Polarix/kicad_libs_append/3d_model/JST1.25mm_2P_Ver_THT.stp

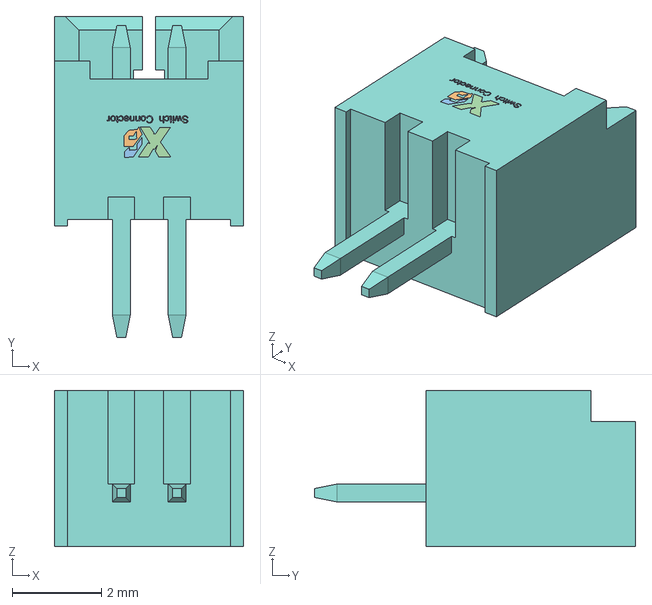
[picture p1: CAD file, 2026-07-21]
3d_model/JST1.25mm_2P_Ver_THT.stp
4.25 x 7.20 x 3.50 mm
