Polarix/kicad_libs_append/3d_model/JST1.25mm_6P_Hor_THT.stp

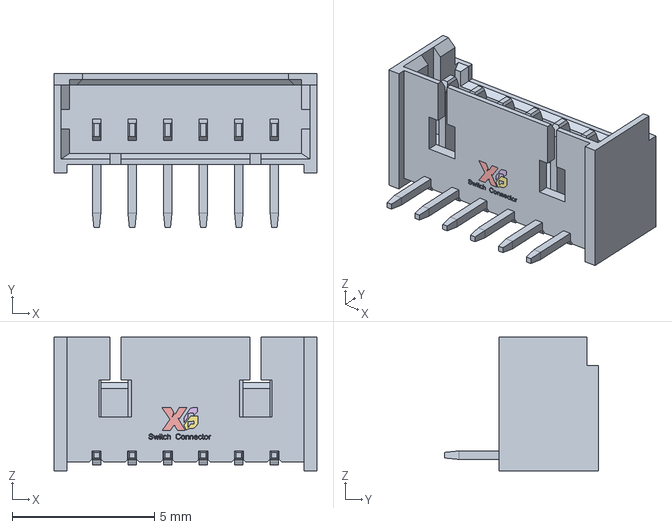
[picture p3: CAD file, 2026-07-21]
3d_model/JST1.25mm_6P_Hor_THT.stp
9.25 x 5.40 x 4.70 mm
