Polarix/kicad_libs_append/3d_model/JST1.25mm_3P_Ver_THT.stp

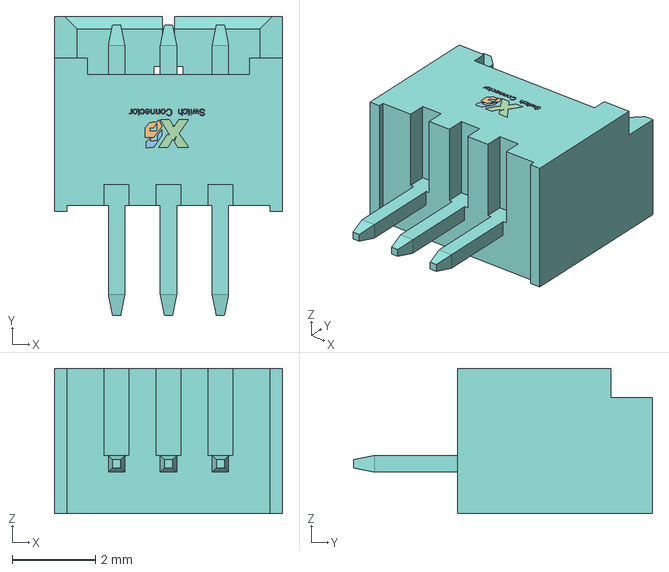
[picture p6: CAD file, 2026-07-21]
3d_model/JST1.25mm_3P_Ver_THT.stp
5.50 x 7.20 x 3.50 mm
