Polarix/kicad_libs_append/3d_model/JST1.25mm_3P_Hor_THT.stp

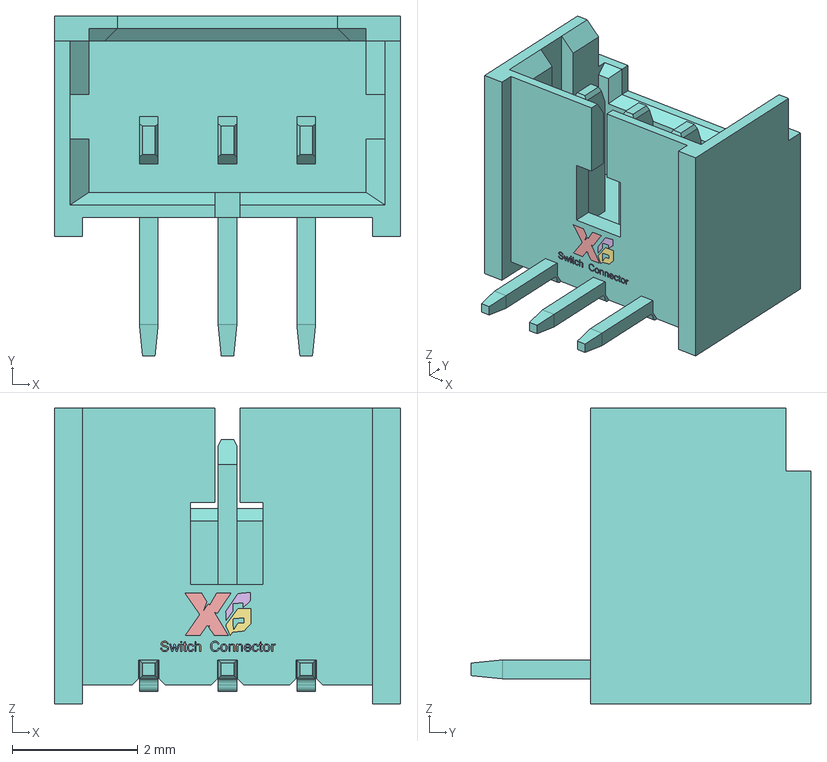
[picture p7: CAD file, 2026-07-21]
3d_model/JST1.25mm_3P_Hor_THT.stp
5.50 x 5.40 x 4.70 mm
