Polarix/kicad_libs_append/3d_model/JST1.25mm_3P_Hor_SMD.stp

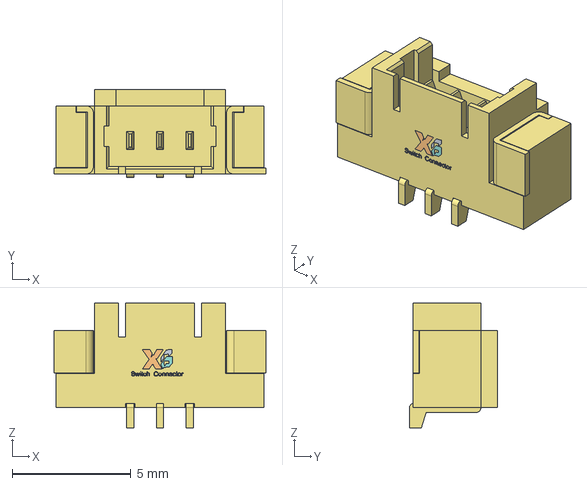
[picture p8: CAD file, 2026-07-21]
3d_model/JST1.25mm_3P_Hor_SMD.stp
8.91 x 3.70 x 5.25 mm
