Polarix/kicad_libs_append/3d_model/JST1.25mm_4P_Ver_THT.stp

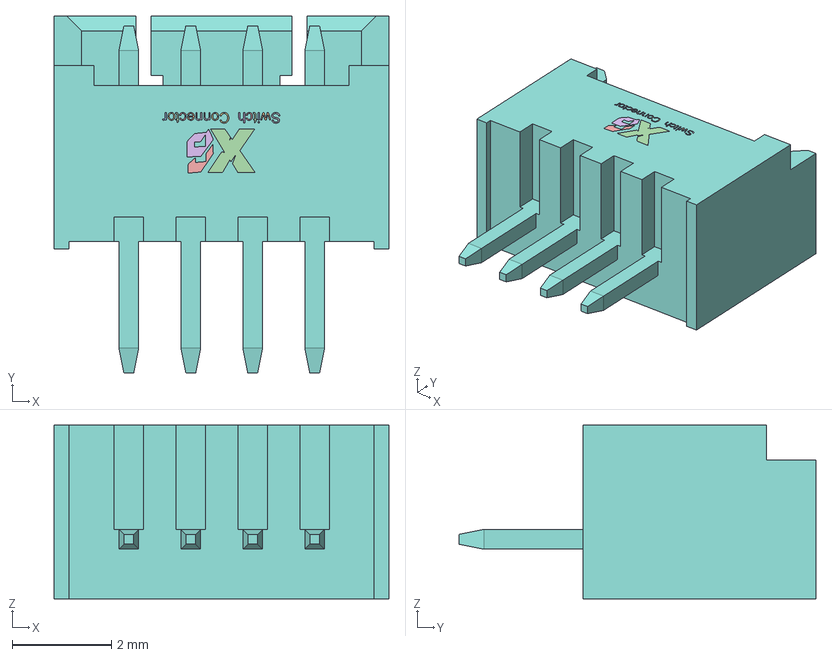
[picture p10: CAD file, 2026-07-21]
3d_model/JST1.25mm_4P_Ver_THT.stp
6.75 x 7.20 x 3.50 mm
