Polarix/kicad_libs_append/3d_model/USB-Type-A_2.0_4P_Sinking_THT.stp

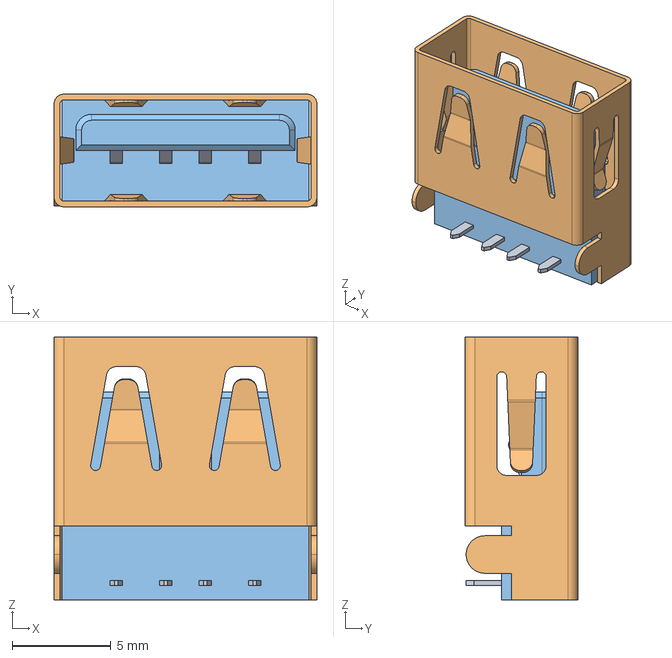
[picture p13: CAD file, 2026-07-18]
3d_model/USB-Type-A_2.0_4P_Sinking_THT.stp
13.3 x 5.70 x 13.3 mm
