Polarix/kicad_libs_append/3d_model/USB-Type-A_3.0_9P_Sinking_SMD.stp

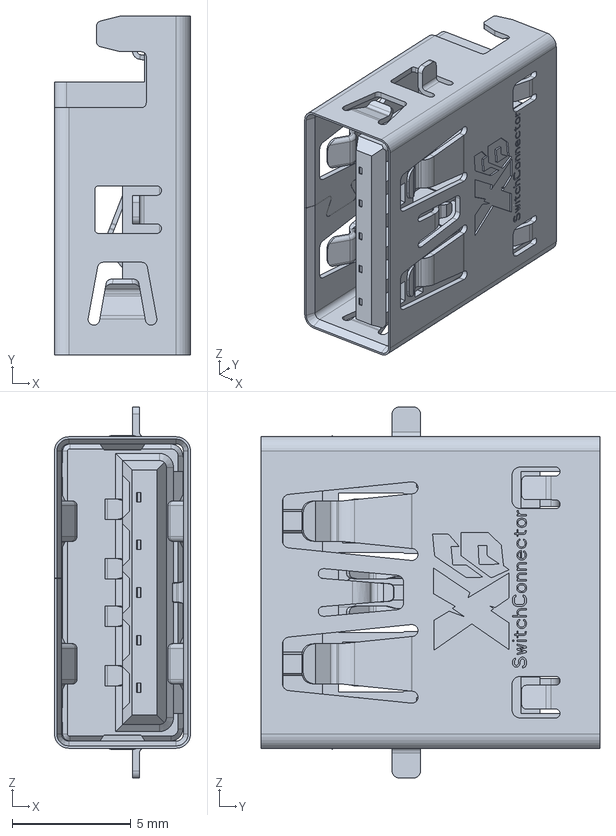
[picture p14: CAD file, 2026-07-18]
3d_model/USB-Type-A_3.0_9P_Sinking_SMD.stp
5.72 x 14.3 x 15.6 mm
