Polarix/kicad_libs_append/3d_model/USB-Type-A_2.0_4P_Sinking_SMD_Short.step

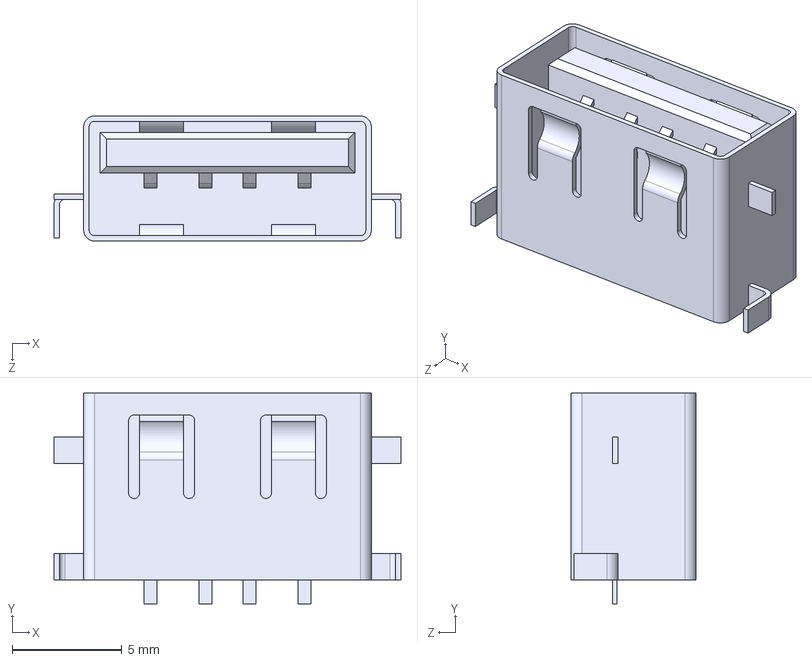
[picture p15: CAD file, 2026-07-18]
3d_model/USB-Type-A_2.0_4P_Sinking_SMD_Short.step
15.8 x 9.60 x 5.70 mm
