Polarix/kicad_libs_append/3d_model/USB-Type-C_16P_sinking_1.6mm.stp

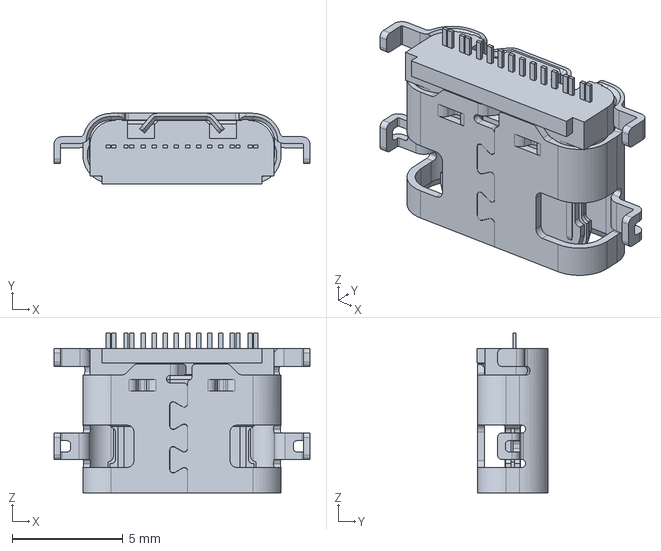
[picture p16: CAD file, 2026-07-18]
3d_model/USB-Type-C_16P_sinking_1.6mm.stp
11.5 x 3.18 x 7.20 mm
