Polarix/kicad_libs_append/3d_model/USB-Type-C_6P_sinking_1.6mm.step

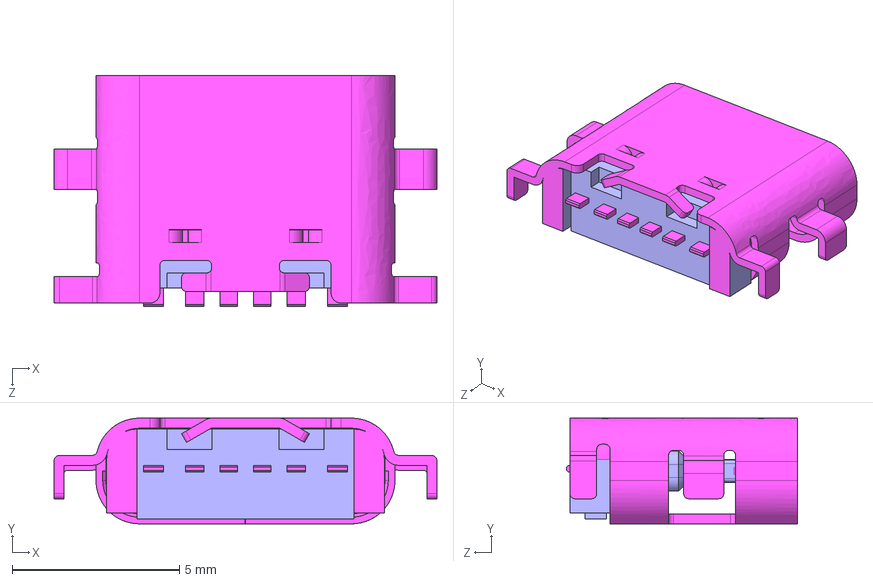
[picture p17: CAD file, 2026-07-18]
3d_model/USB-Type-C_6P_sinking_1.6mm.step
11.5 x 3.16 x 6.90 mm
