Polarix/kicad_libs_append/3d_model/USB-Type-C_6P_sinking_0.8mm.STEP

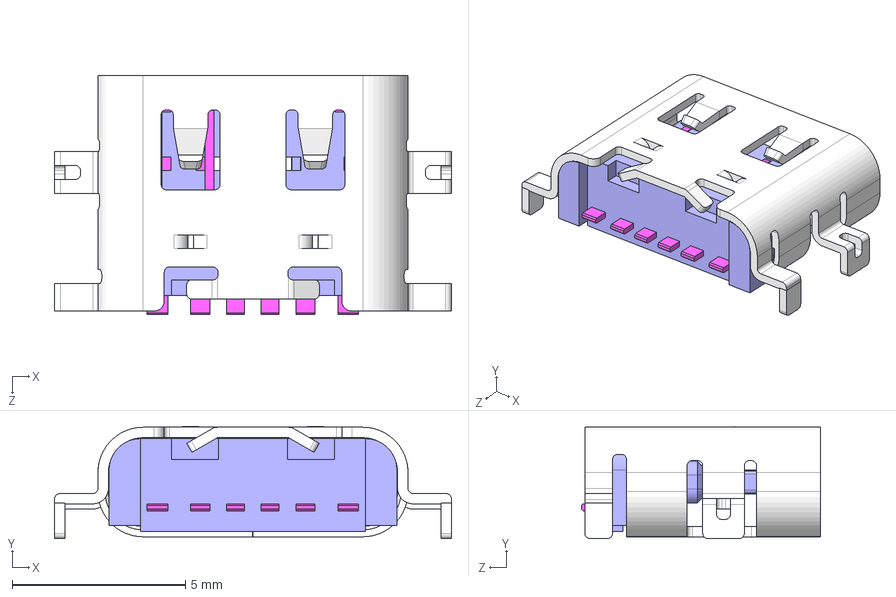
[picture p18: CAD file, 2026-07-18]
3d_model/USB-Type-C_6P_sinking_0.8mm.STEP
11.4 x 3.23 x 6.90 mm
MANIFOLD_SOLID_BREP_50936.STP
MANIFOLD_SOLID_BREP_51217.STP
MANIFOLD_SOLID_BREP_51498.STP
MANIFOLD_SOLID_BREP_53168.STP
MANIFOLD_SOLID_BREP_54906.STP
MANIFOLD_SOLID_BREP_56957.STP
MANIFOLD_SOLID_BREP_58597.STP
MANIFOLD_SOLID_BREP_60641.STP
MANIFOLD_SOLID_BREP_62379.STP
BOTTOM-HOUSING0_3.STP
