Polarix/kicad_libs_append/3d_model/MX1.25-7P_THT.stp

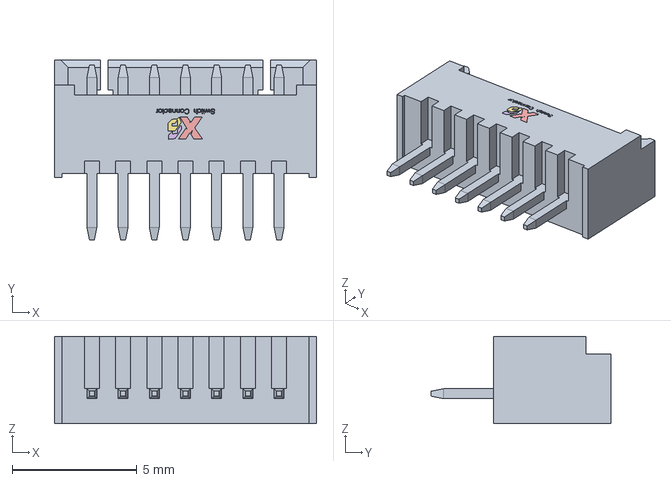
[picture p19: CAD file, 2026-05-09]
3d_model/MX1.25-7P_THT.stp
10.5 x 7.20 x 3.50 mm
