Polarix/kicad_libs_append/3d_model/MX1.25-4P_SMD_V.stp

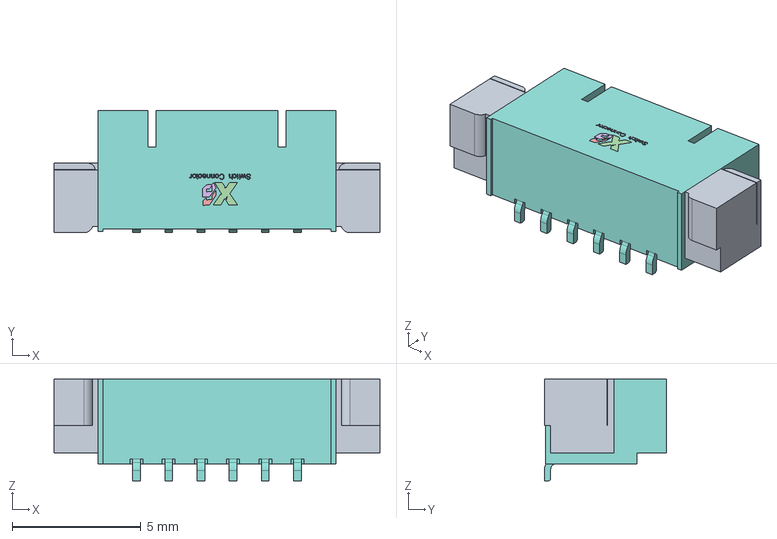
[picture p20: CAD file, 2026-05-09]
3d_model/MX1.25-4P_SMD_V.stp
12.7 x 4.75 x 3.95 mm
