Polarix/kicad_libs_append/3d_model/MX1.25-11P_THT.stp

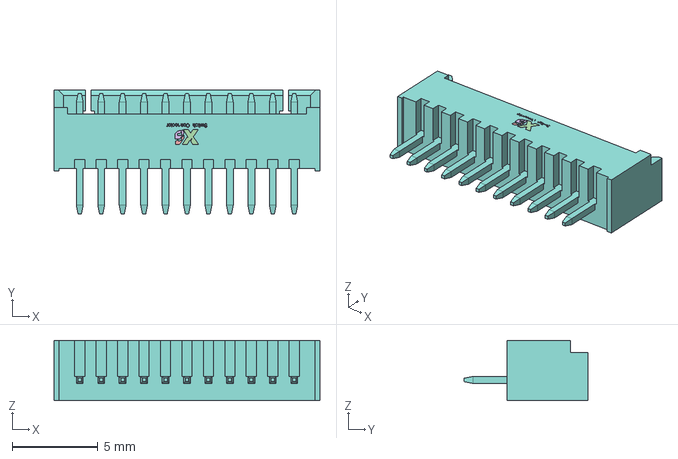
[picture p21: CAD file, 2026-05-09]
3d_model/MX1.25-11P_THT.stp
15.5 x 7.20 x 3.50 mm
