Polarix/kicad_libs_append/3d_model/KF2510-4P.step

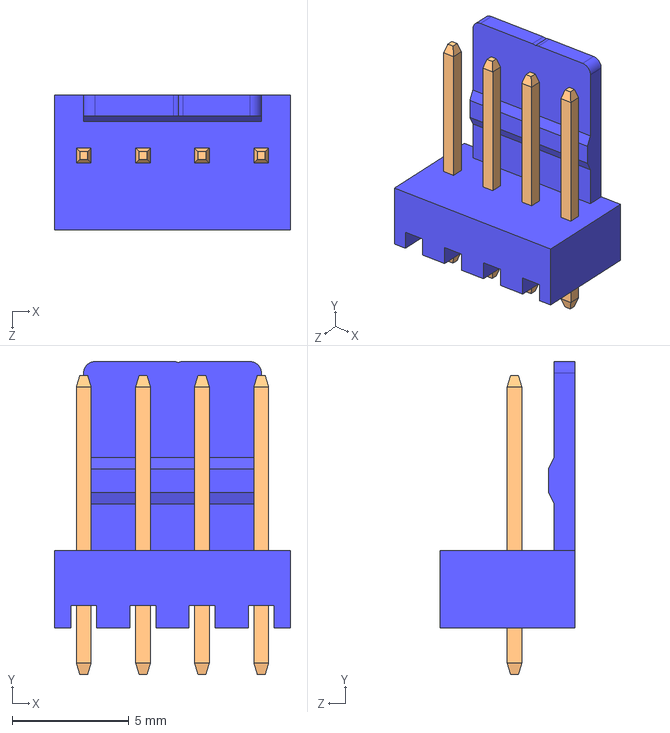
[picture p22: CAD file, 2026-04-30]
3d_model/KF2510-4P.step
10.1 x 13.4 x 5.80 mm
