Polarix/kicad_libs_append/3d_model/ML307.step

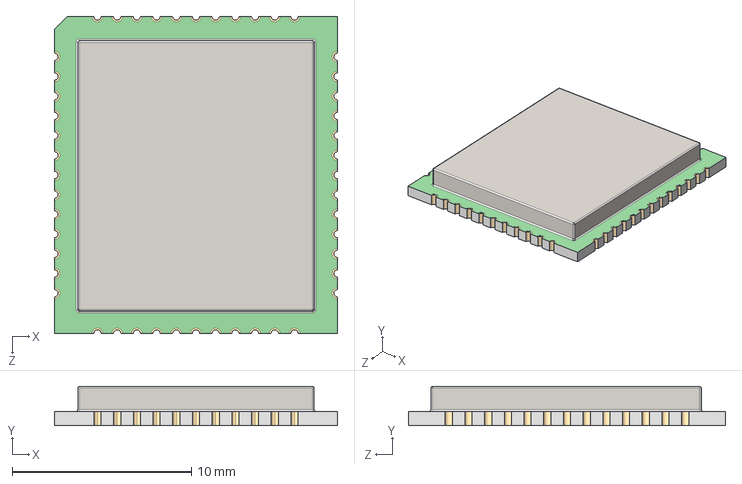
[picture p23: CAD file, 2026-04-30]
3d_model/ML307.step
15.8 x 2.20 x 17.7 mm
