Polarix/kicad_libs_append/3d_model/KF2510-4P_Hor.step

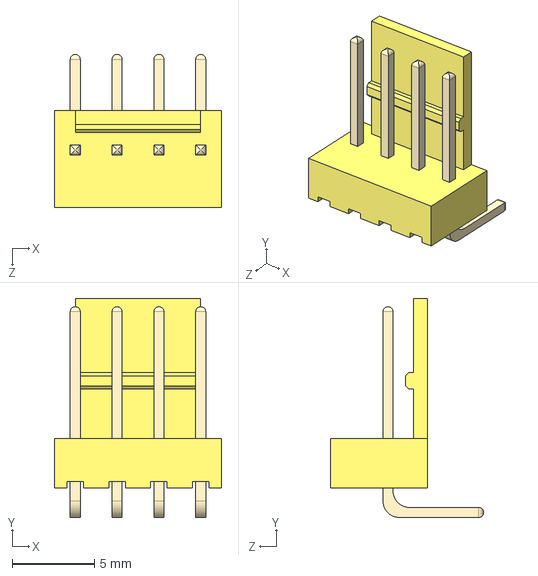
[picture p24: CAD file, 2026-04-01]
3d_model/KF2510-4P_Hor.step
10.2 x 13.3 x 9.31 mm
