Polarix/kicad_libs_append/3d_model/USB-Type-C_16P_sinking_0.8mm.STEP

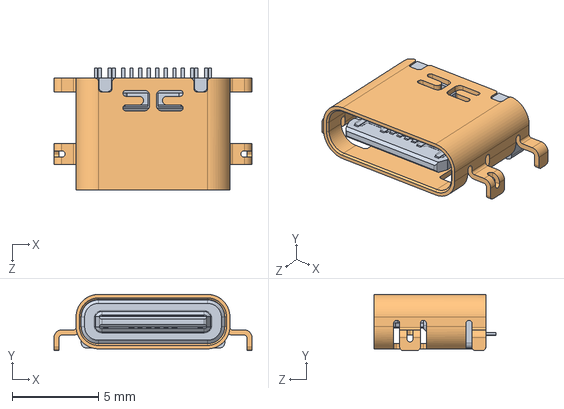
[picture p25: CAD file, 2026-04-01]
3d_model/USB-Type-C_16P_sinking_0.8mm.STEP
11.5 x 3.26 x 7.10 mm
____6^mid-16PIN ____0.8 mm.STEP
shell.STEP
