Polarix/kicad_libs_append/3d_model/TF-Card_push-slot-9P_with_card.step

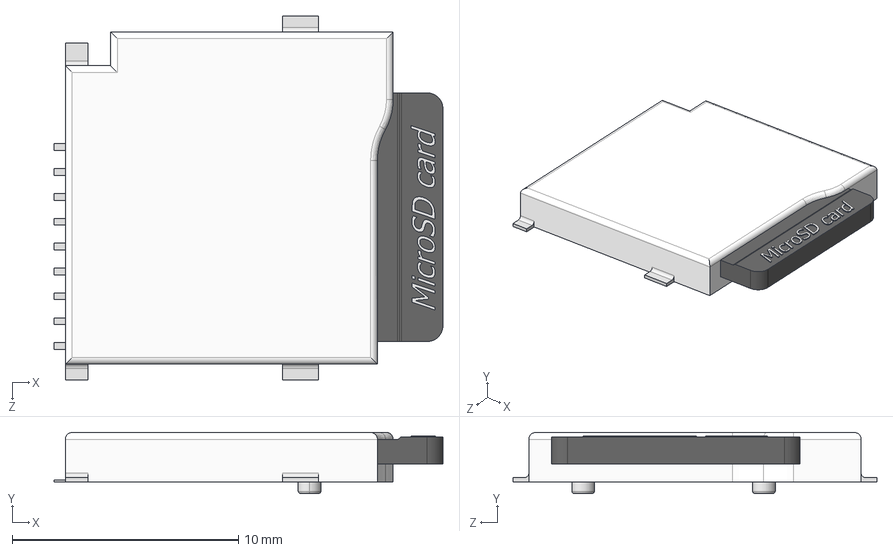
[picture p26: CAD file, 2026-04-01]
3d_model/TF-Card_push-slot-9P_with_card.step
17.2 x 2.70 x 16.1 mm
