Polarix/kicad_libs_append/3d_model/D2FC-F-7N.stp

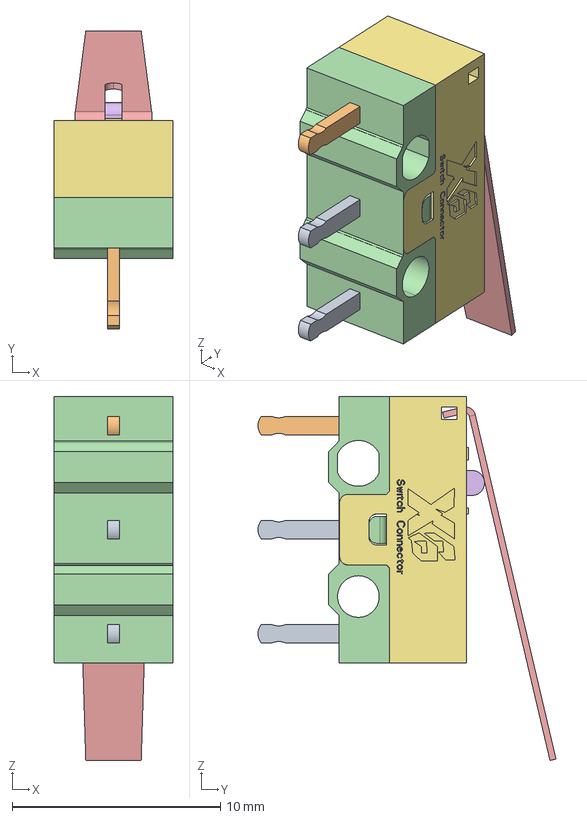
[picture p27: CAD file, 2026-03-24]
3d_model/D2FC-F-7N.stp
5.70 x 14.3 x 17.5 mm
_X2_5F397247_X0__1_-1-SOLID1_17
_X2_4E0B_X0__1_-1-SOLID1_1_2_17
17_9_X2_5F397247_X0_2_65-3_7__2
_X2_6309952E_X0__1_-1-SOLID1_17
_X2_4E0A76D6_X0_3_7_1_2_3_4
