Polarix/kicad_libs_append/3d_model/GH1.25-4P-180.step

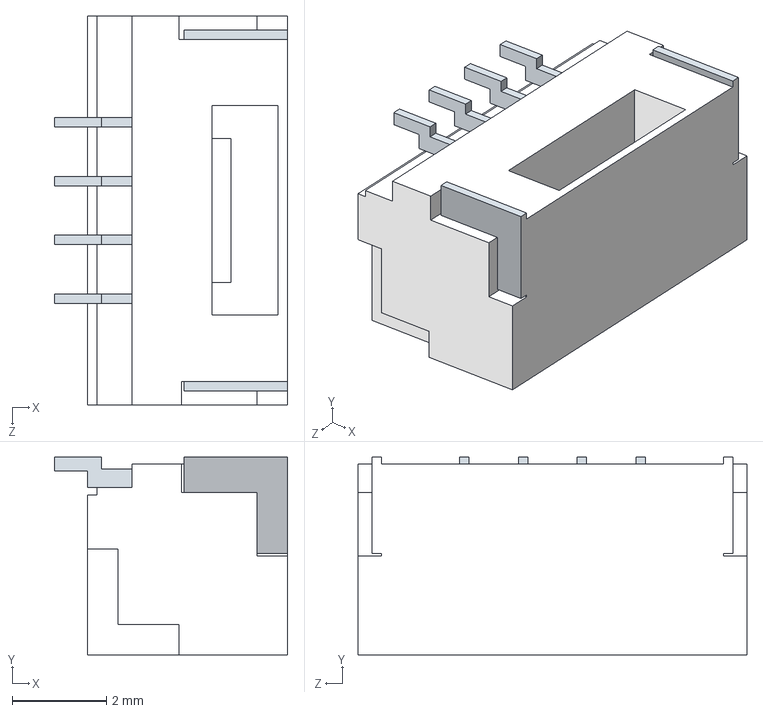
[picture p30: CAD file, 2026-03-21]
3d_model/GH1.25-4P-180.step
4.95 x 4.20 x 8.26 mm
