Polarix/kicad_libs_append/3d_model/GH1.25-4P-90.step

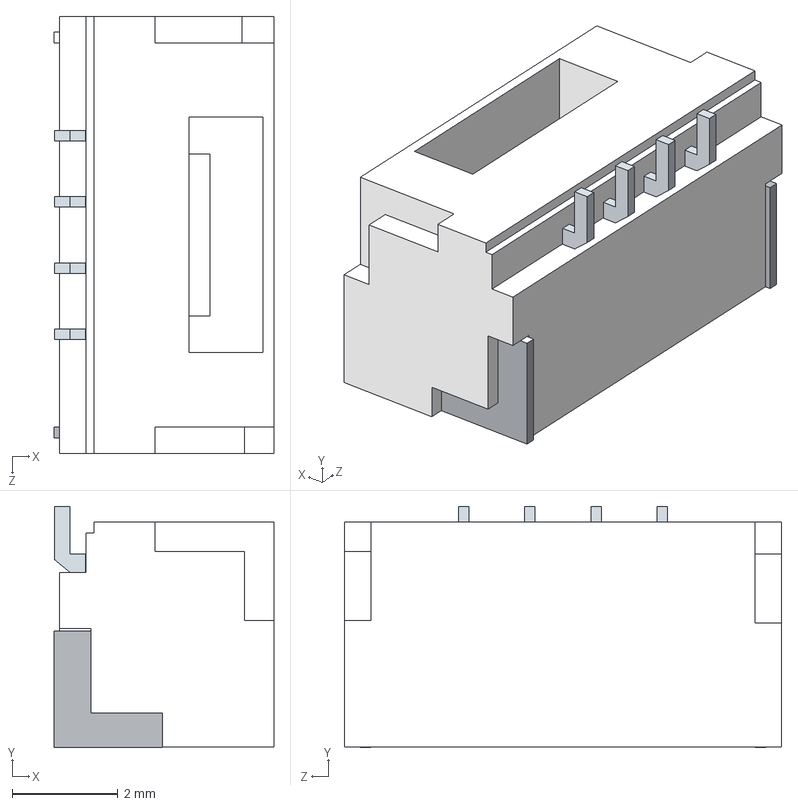
[picture p31: CAD file, 2026-03-21]
3d_model/GH1.25-4P-90.step
4.16 x 4.55 x 8.26 mm
