Polarix/kicad_libs_append/3d_model/GH1.25-13P-90.step

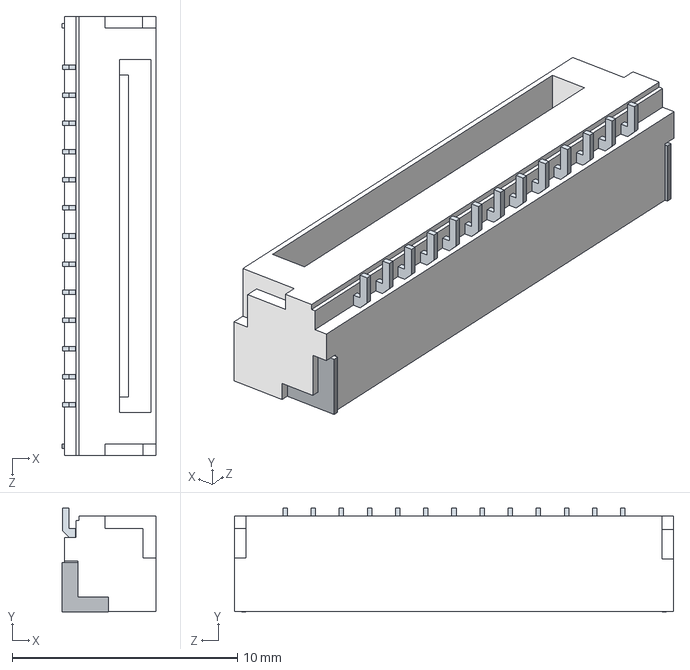
[picture p34: CAD file, 2026-03-21]
3d_model/GH1.25-13P-90.step
4.16 x 4.61 x 19.5 mm
