Polarix/kicad_libs_append/3d_model/GH1.25-5P-90.step

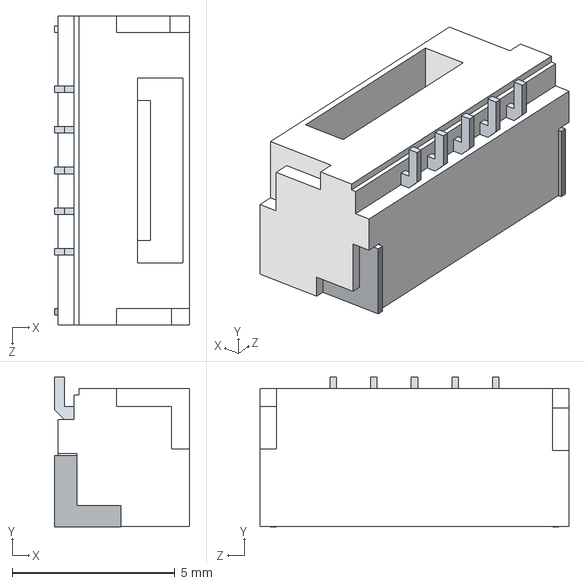
[picture p36: CAD file, 2026-03-21]
3d_model/GH1.25-5P-90.step
4.16 x 4.61 x 9.50 mm
