Polarix/kicad_libs_append/3d_model/GH1.25-10P-180.step

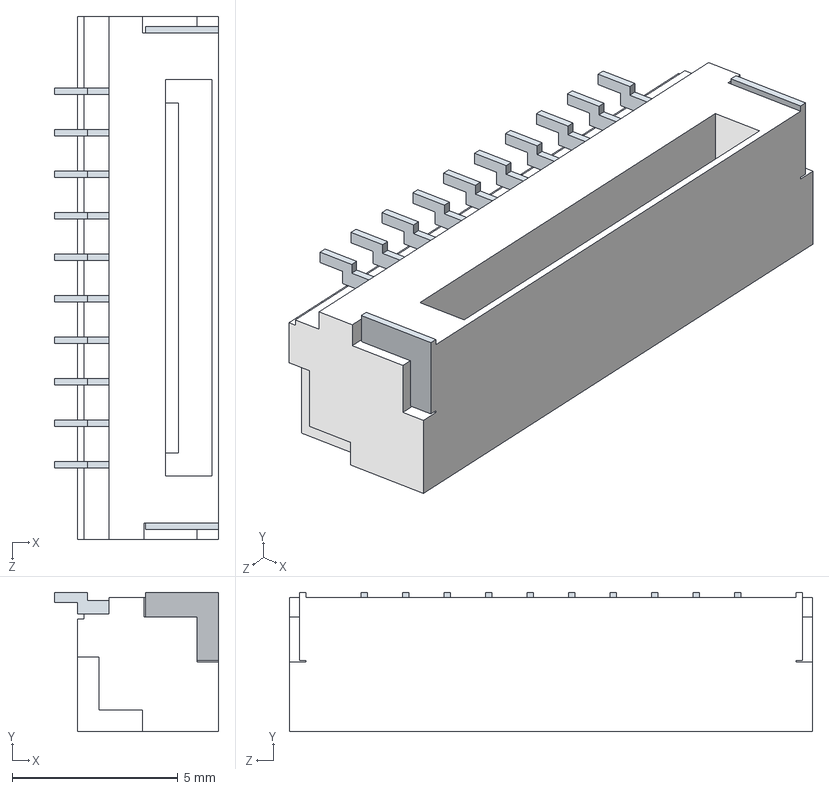
[picture p46: CAD file, 2026-03-21]
3d_model/GH1.25-10P-180.step
4.95 x 4.20 x 15.8 mm
