Polarix/kicad_libs_append/3d_model/GH1.25-2P-90.step

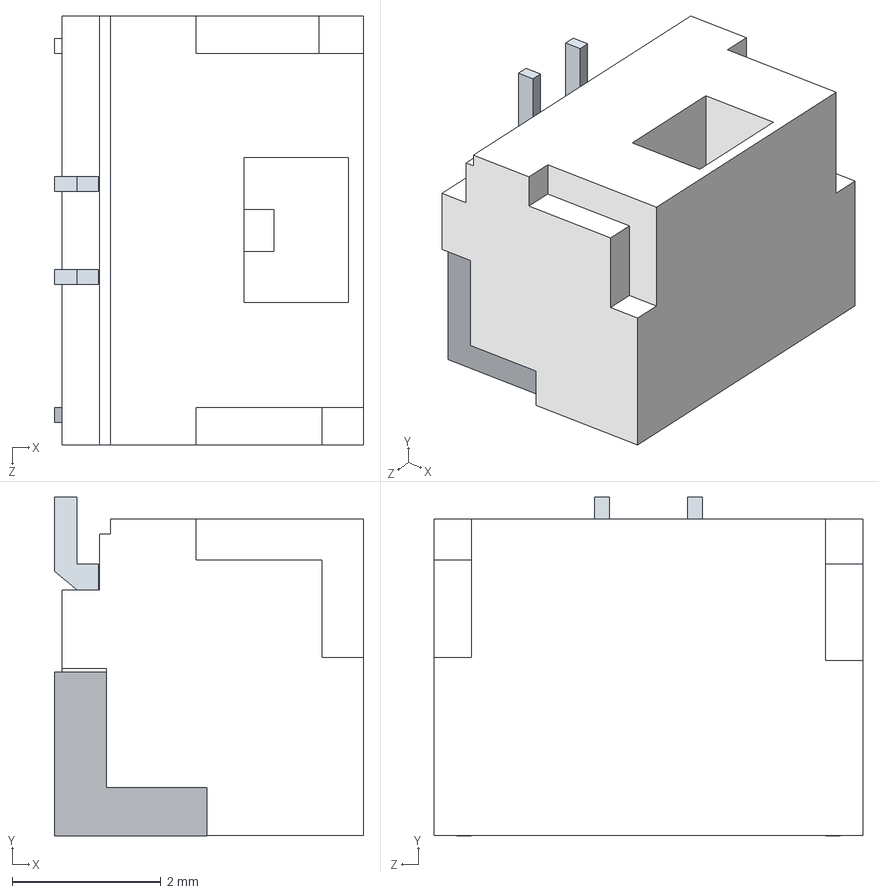
[picture p48: CAD file, 2026-03-21]
3d_model/GH1.25-2P-90.step
4.16 x 4.55 x 5.76 mm
