Polarix/kicad_libs_append/3d_model/MSM261S3526Z0CM.STEP

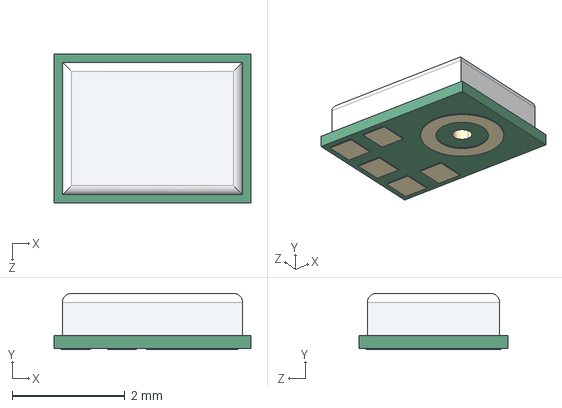
[picture p52: CAD file, 2025-12-02]
3d_model/MSM261S3526Z0CM.STEP
3.50 x 1.00 x 2.65 mm
