Polarix/kicad_libs_append/3d_model/MSK-12C01.STEP

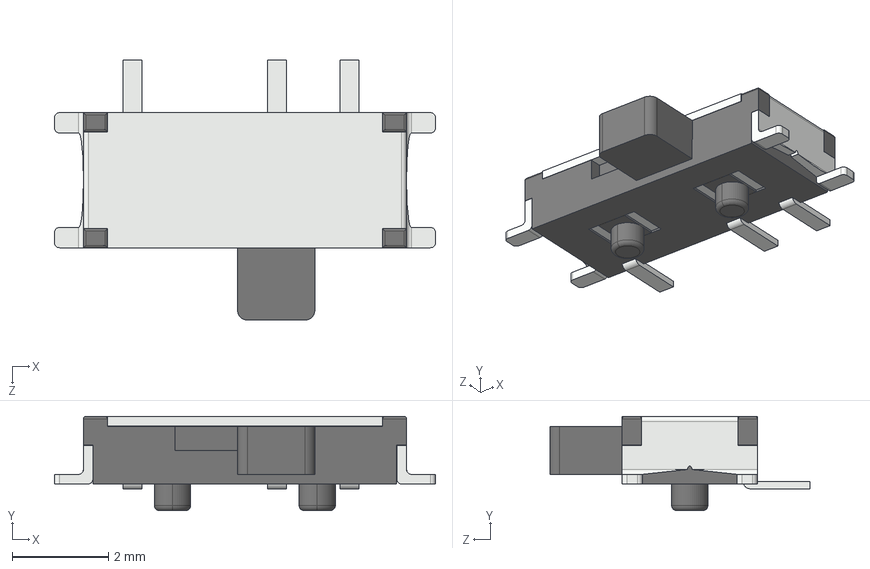
[picture p53: CAD file, 2025-09-04]
3d_model/MSK-12C01.STEP
7.90 x 1.95 x 5.39 mm
