Polarix/kicad_libs_append/3d_model/MSK-12C02.STEP

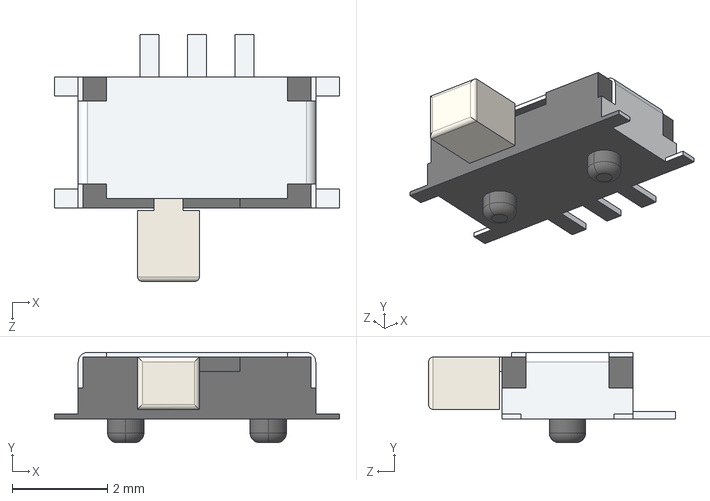
[picture p54: CAD file, 2025-09-04]
3d_model/MSK-12C02.STEP
6.00 x 1.90 x 5.20 mm
