Polarix/kicad_libs_append/3d_model/Pot-3313J-2.STEP

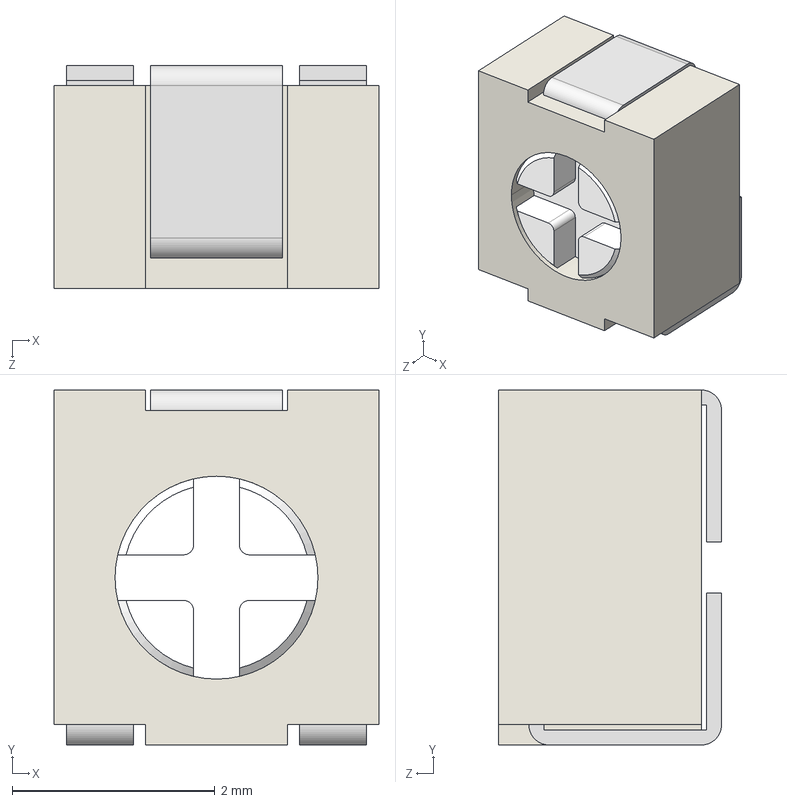
[picture p56: CAD file, 2025-06-06]
3d_model/Pot-3313J-2.STEP
3.20 x 3.50 x 2.20 mm
3313_body
3313_screw
3313_terminal
3313_terminal_2 x 2
