Polarix/kicad_libs_append/3d_model/Pot-3314J.stp

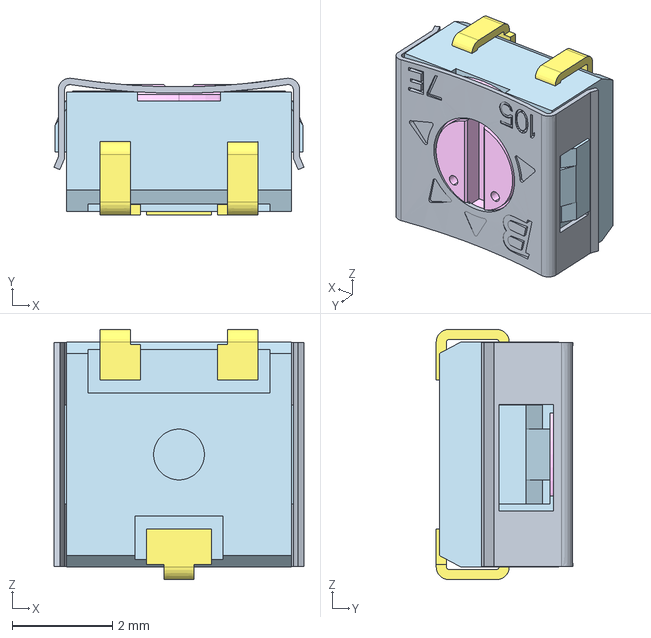
[picture p57: CAD file, 2025-06-06]
3d_model/Pot-3314J.stp
5.00 x 2.73 x 5.00 mm
