Polarix/kicad_libs_append/3d_model/PH2_0-6P_WB.STEP

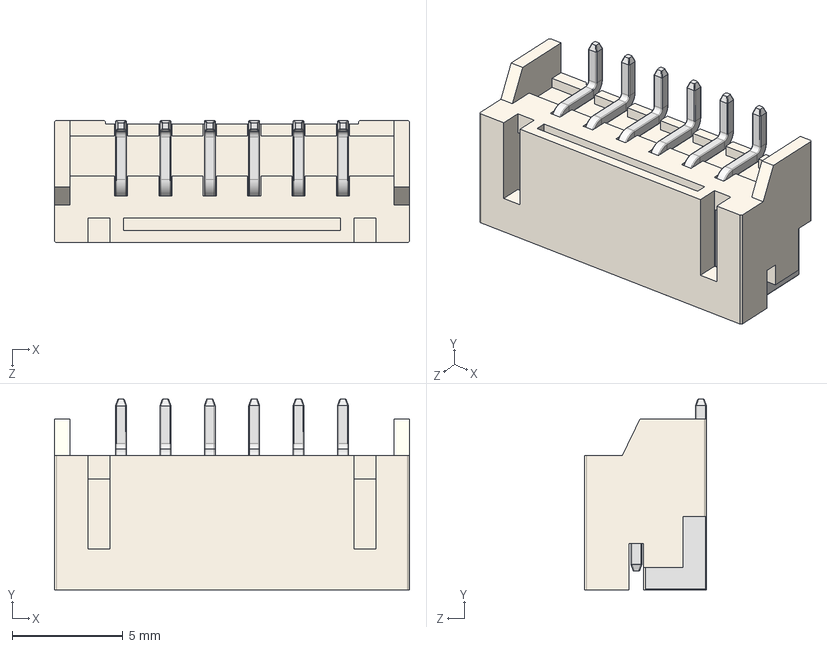
[picture p58: CAD file, 2025-05-28]
3d_model/PH2_0-6P_WB.STEP
16.0 x 8.60 x 5.50 mm
3_1_2_3_400.STP
2_1_2_3_400.STP
1_1_2_3_4_A.STP
PH2_0_SMD-W__1_2_30002.STP x 6
