Polarix/kicad_libs_append/3d_model/PH2.0-2P_WB.STEP

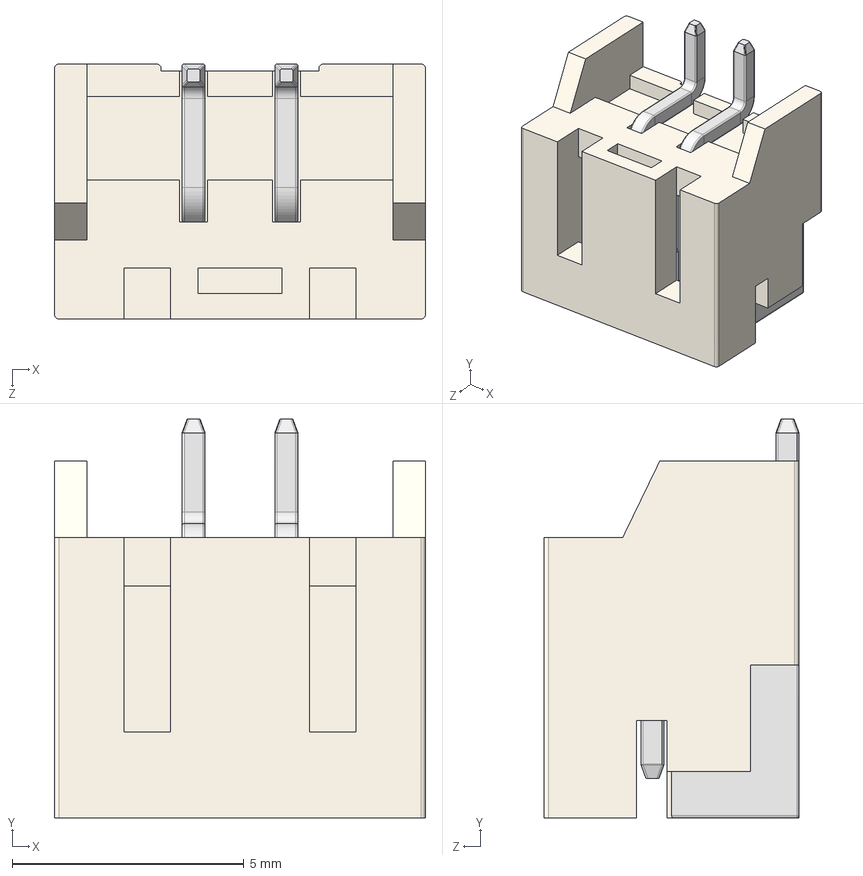
[picture p59: CAD file, 2025-05-28]
3d_model/PH2.0-2P_WB.STEP
8.00 x 8.60 x 5.50 mm
1_A.STP
200.STP
300.STP
PH2_0_SMD-W_00.STP x 2
