Polarix/kicad_libs_append/3d_model/PH2_0-5P_WB.STEP

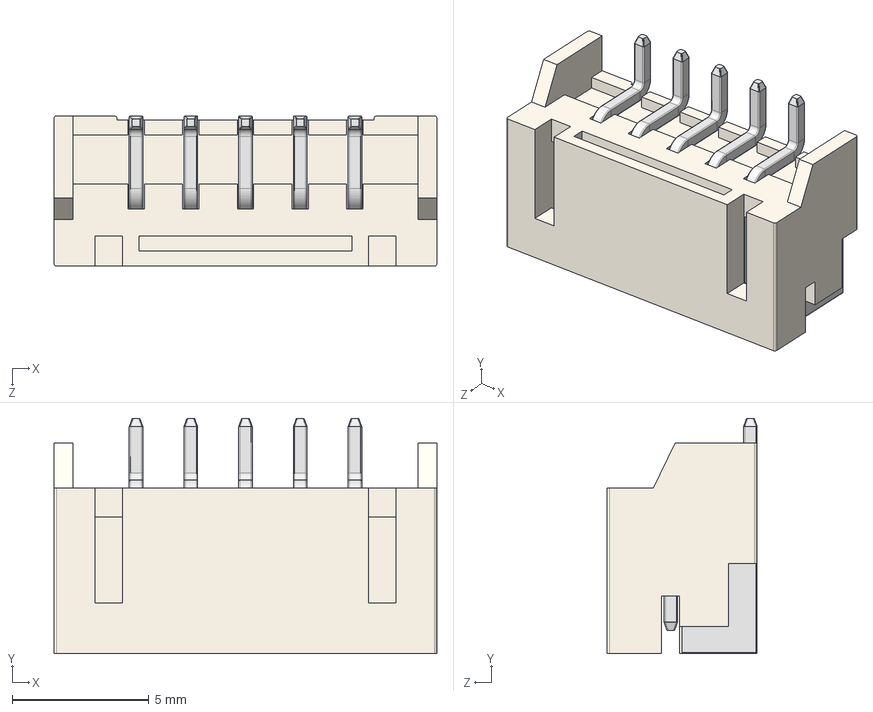
[picture p61: CAD file, 2025-05-28]
3d_model/PH2_0-5P_WB.STEP
14.0 x 8.60 x 5.50 mm
2_1_2_300.STP
1_1_2_3_A.STP
3_1_2_300.STP
PH2_0_SMD-W__1_2_300.STP x 5
