Polarix/kicad_libs_append/3d_model/PH2.0-4P_WB.STEP

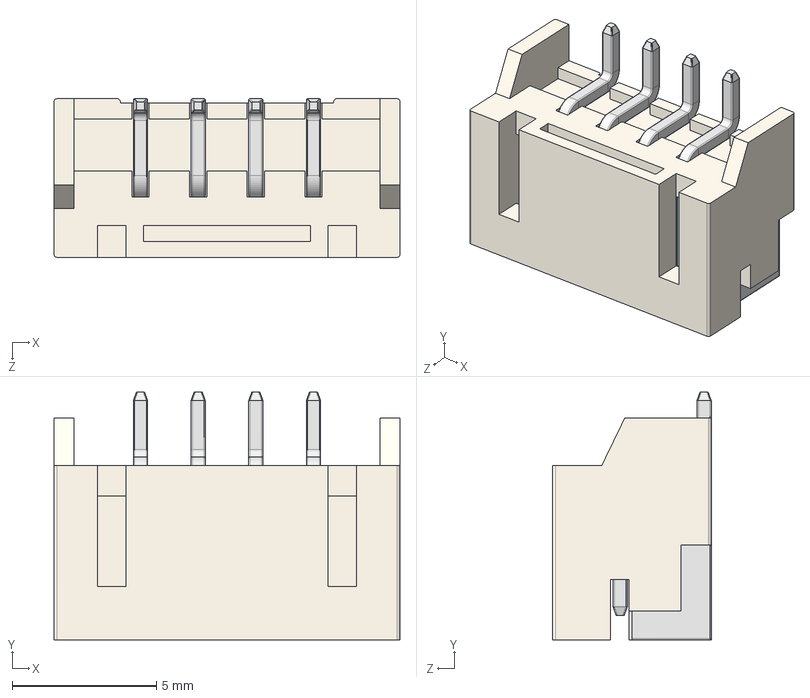
[picture p62: CAD file, 2025-05-28]
3d_model/PH2.0-4P_WB.STEP
12.0 x 8.60 x 5.50 mm
2_1_200.STP
1_1_2_A.STP
3_1_200.STP
PH2_0_SMD-W__1_200.STP x 4
