Polarix/kicad_libs_append/3d_model/PH2.0-3P_WB.STEP

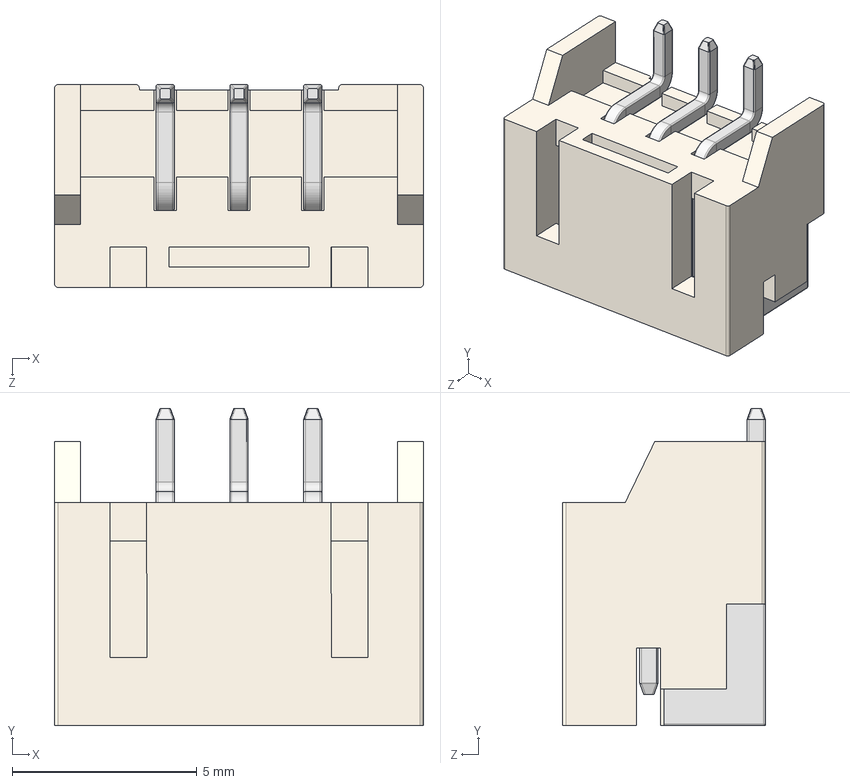
[picture p63: CAD file, 2025-05-28]
3d_model/PH2.0-3P_WB.STEP
10.0 x 8.60 x 5.50 mm
3_100.STP
2_100.STP
1_1_A.STP
PH2_0_SMD-W__100.STP x 3
