Polarix/kicad_libs_append/3d_model/PH2_0-9P_WB.STEP

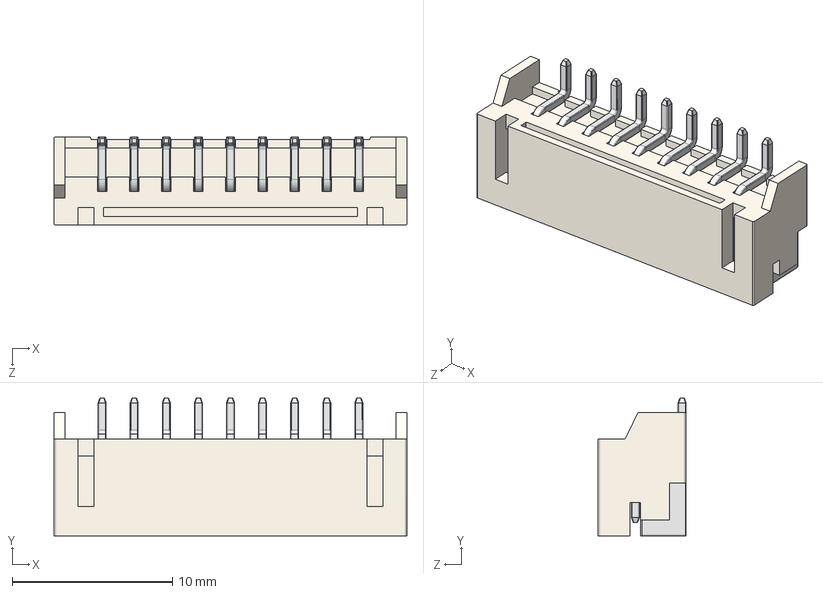
[picture p64: CAD file, 2025-05-28]
3d_model/PH2_0-9P_WB.STEP
22.0 x 8.60 x 5.50 mm
2_1_2_3_4_5_6_700.STP
1_1_2_3_4_5_6_700.STP
3_1_2_3_4_5_6_700.STP
PH2_0_SMD-W__1_2_30005.STP x 9
