Polarix/kicad_libs_append/3d_model/PH2_0-8P_WB.STEP

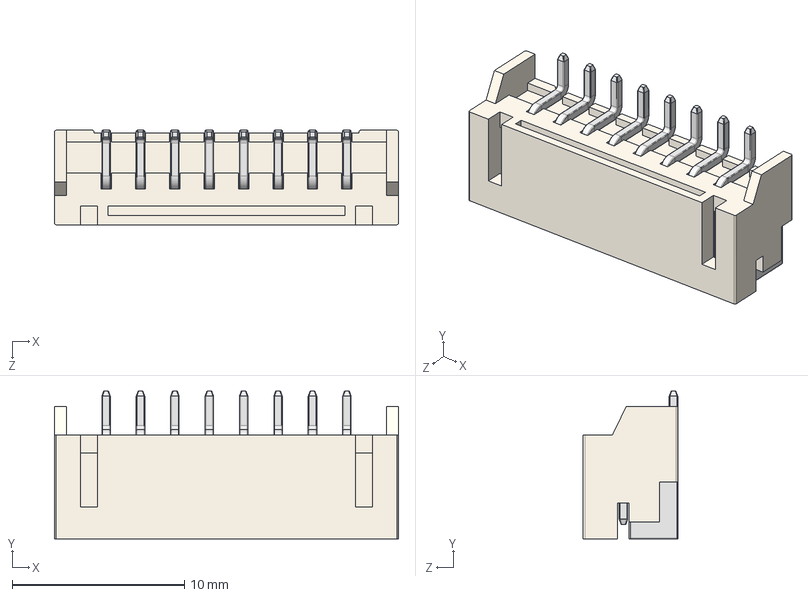
[picture p65: CAD file, 2025-05-28]
3d_model/PH2_0-8P_WB.STEP
20.0 x 8.60 x 5.50 mm
1_1_2_3_4_5_6_A.STP
2_1_2_3_4_5_600.STP
3_1_2_3_4_5_600.STP
PH2_0_SMD-W__1_2_30004.STP x 8
