Polarix/kicad_libs_append/3d_model/4mm_SMD_Button.STEP

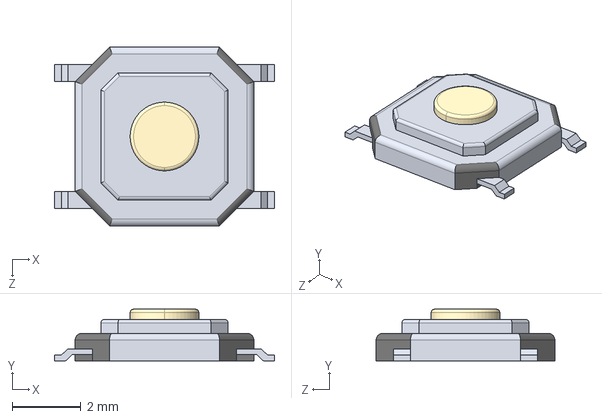
[picture p66: CAD file, 2025-04-02]
3d_model/4mm_SMD_Button.STEP
6.40 x 1.50 x 5.20 mm
