Polarix/kicad_libs_append/3d_model/TS-1070_SMD_Button.stp

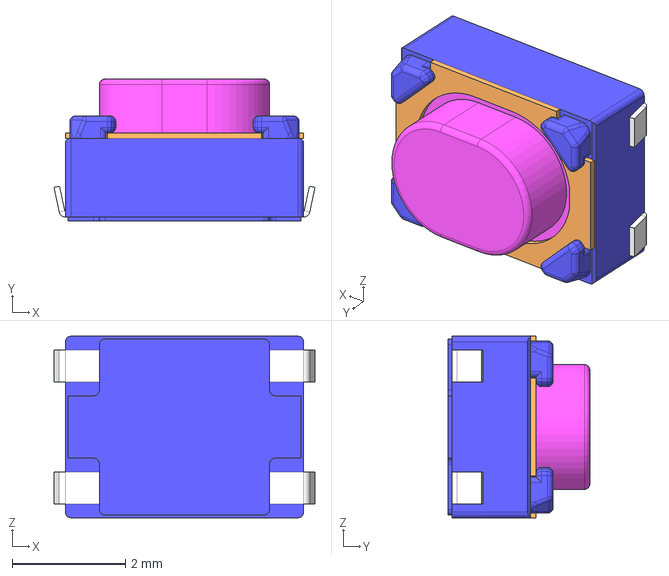
[picture p67: CAD file, 2025-04-02]
3d_model/TS-1070_SMD_Button.stp
4.60 x 2.50 x 3.20 mm
