Polarix/kicad_libs_append/3d_model/TS-1010-XA_SMD_Button.stp

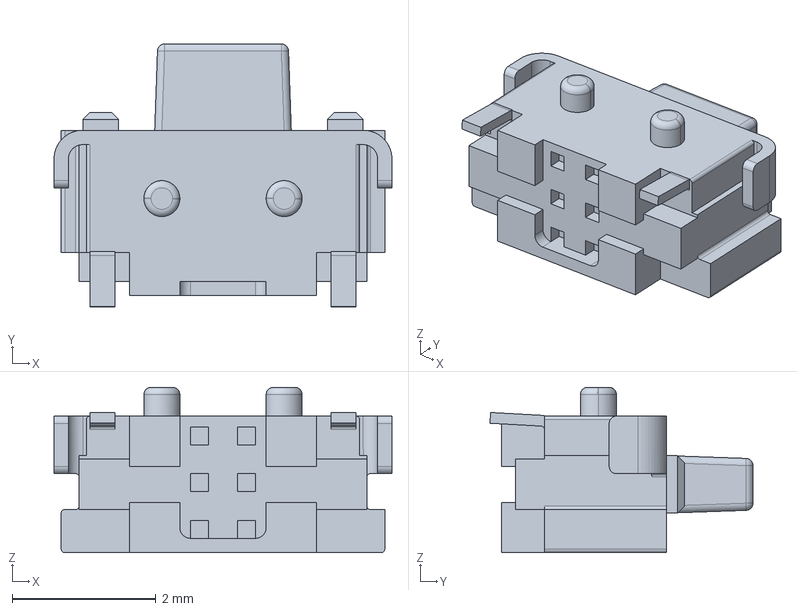
[picture p68: CAD file, 2025-04-02]
3d_model/TS-1010-XA_SMD_Button.stp
4.70 x 3.66 x 2.30 mm
