Polarix/kicad_libs_append/3d_model/TS-1010B_SMD_Button.stp

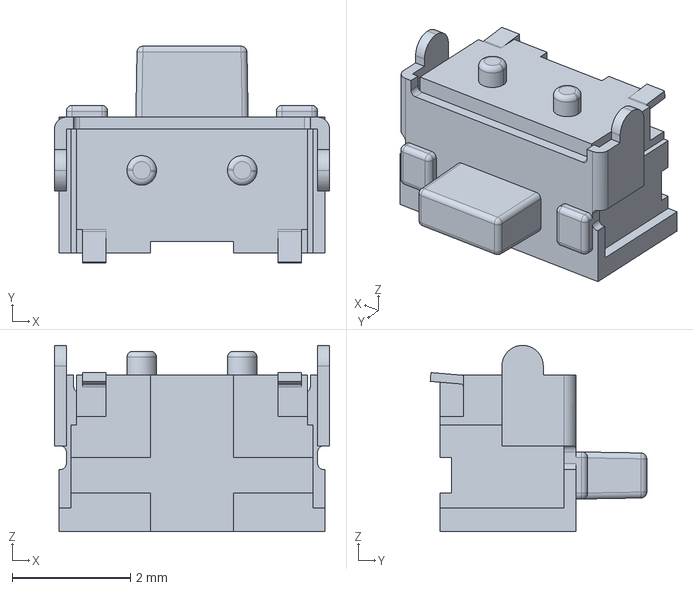
[picture p69: CAD file, 2025-04-02]
3d_model/TS-1010B_SMD_Button.stp
4.65 x 3.66 x 3.15 mm
