Polarix/kicad_libs_append/3d_model/TS-1185_SMD_Button.stp

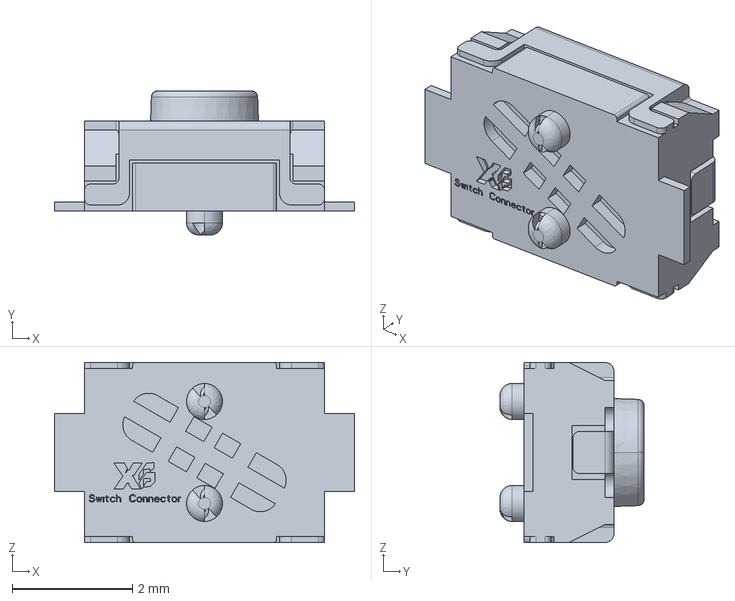
[picture p70: CAD file, 2025-04-02]
3d_model/TS-1185_SMD_Button.stp
5.00 x 2.40 x 3.00 mm
