Polarix/kicad_libs_append/3d_model/RPI-441C1.stp

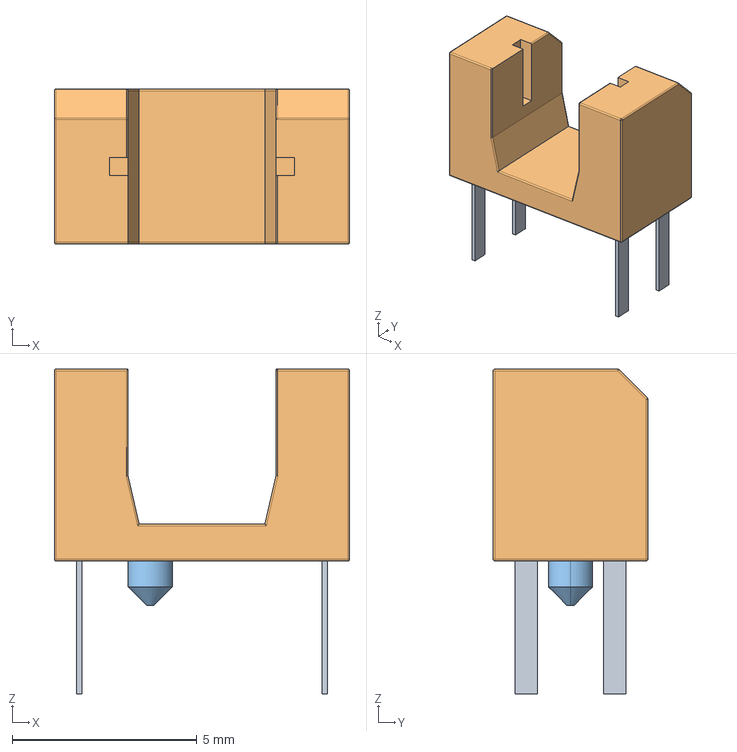
[picture p71: CAD file, 2025-03-26]
3d_model/RPI-441C1.stp
8.00 x 4.20 x 8.80 mm
