Polarix/kicad_libs_append/3d_model/RPI-243.stp

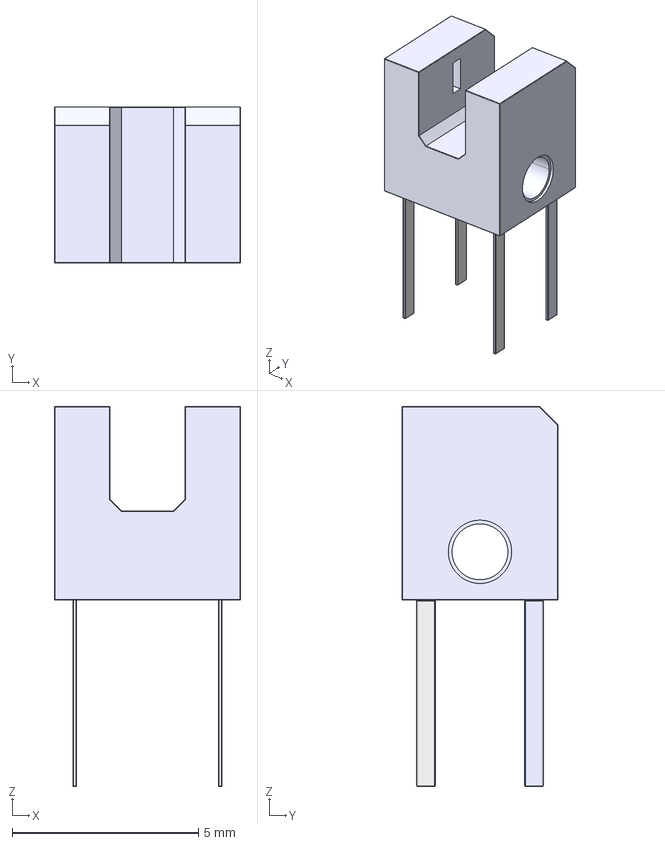
[picture p72: CAD file, 2025-03-26]
3d_model/RPI-243.stp
5.00 x 4.20 x 10.2 mm
