Polarix/kicad_libs_append/3d_model/RPI-221.STEP

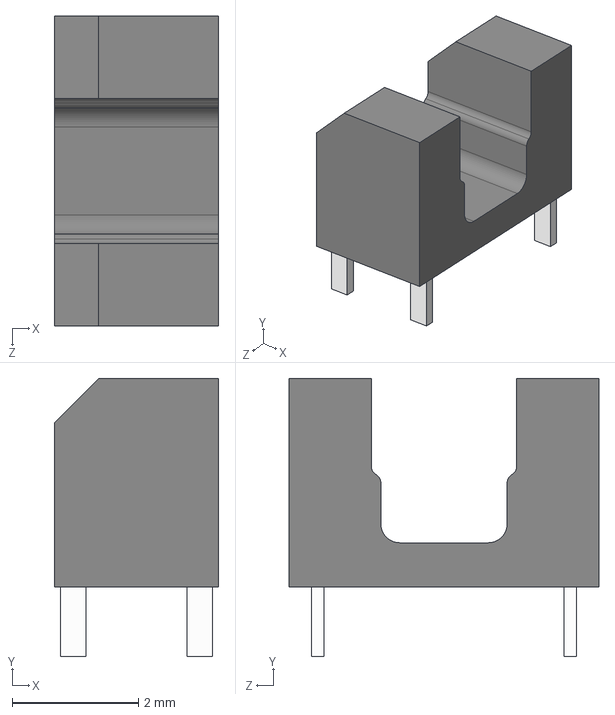
[picture p73: CAD file, 2025-03-26]
3d_model/RPI-221.STEP
2.60 x 4.40 x 4.90 mm
