Polarix/kicad_libs_append/3d_model/Dupont2.54mm_Male_Bent_4Pin.STEP

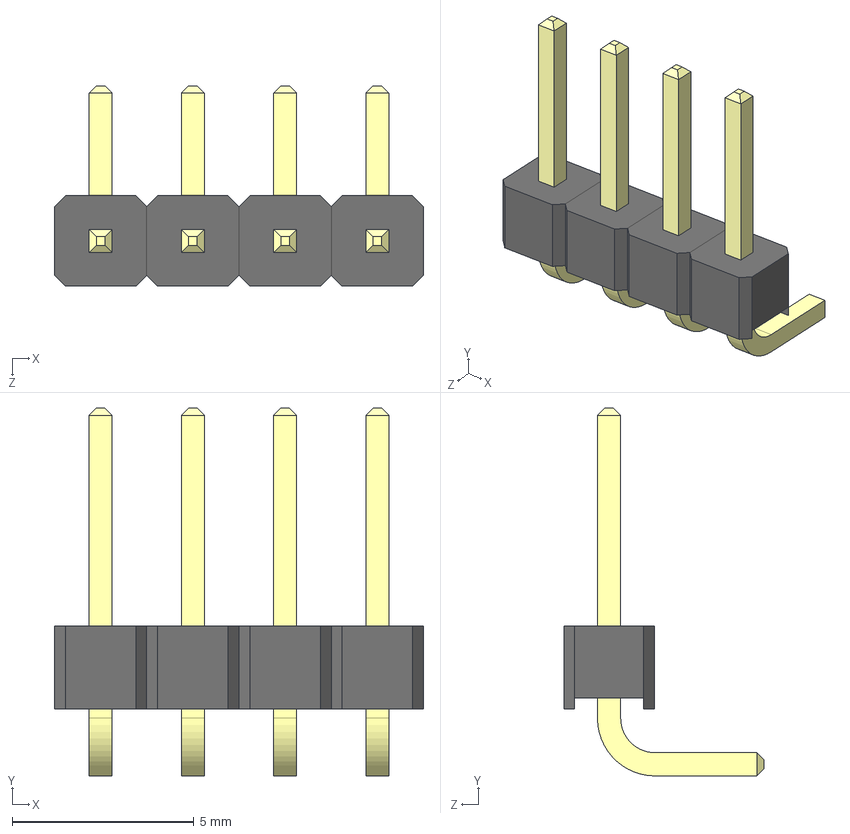
[picture p74: CAD file, 2025-03-25]
3d_model/Dupont2.54mm_Male_Bent_4Pin.STEP
10.2 x 10.1 x 5.52 mm
BodyArray
PinArray
