Polarix/kicad_libs_append/3d_model/Dupont2.54mm_Male_1Pin.STEP

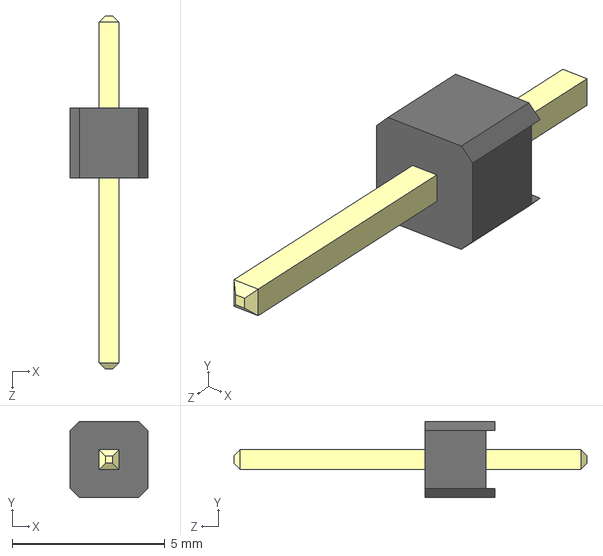
[picture p75: CAD file, 2025-03-25]
3d_model/Dupont2.54mm_Male_1Pin.STEP
2.54 x 2.49 x 11.5 mm
PinArray
BodyArray
