Polarix/kicad_libs_append/3d_model/Dupont2.54mm_Male_7Pin.STEP

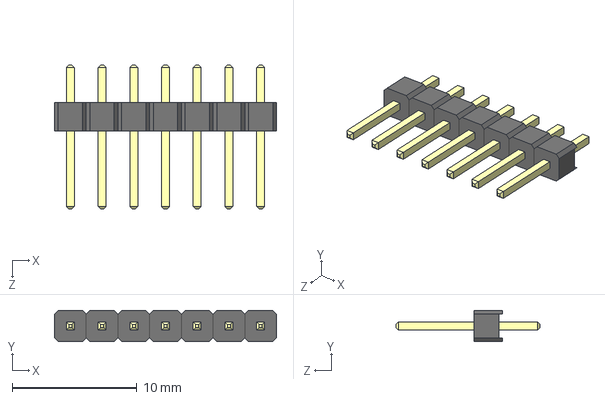
[picture p76: CAD file, 2025-03-25]
3d_model/Dupont2.54mm_Male_7Pin.STEP
17.8 x 2.49 x 11.5 mm
PinArray
BodyArray
