Polarix/kicad_libs_append/3d_model/Dupont2.54mm_Male_40Pin.STEP

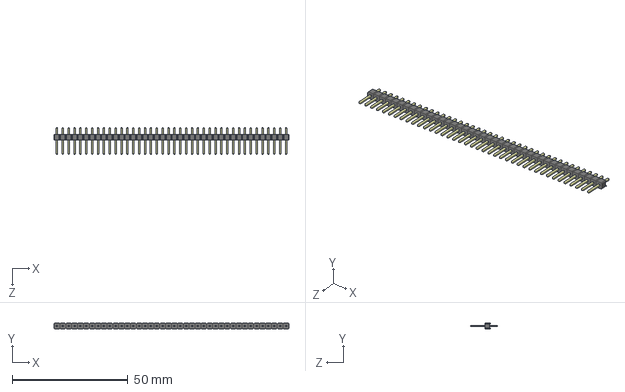
[picture p79: CAD file, 2025-03-25]
3d_model/Dupont2.54mm_Male_40Pin.STEP
101.6 x 2.49 x 11.5 mm
BodyArray
PinArray
