Polarix/kicad_libs_append/3d_model/Dupont2.54mm_Male_3Pin.STEP

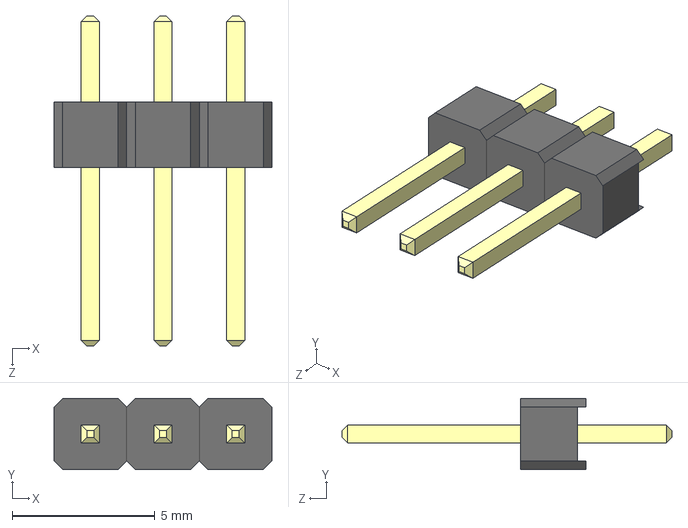
[picture p80: CAD file, 2025-03-25]
3d_model/Dupont2.54mm_Male_3Pin.STEP
7.62 x 2.49 x 11.5 mm
PinArray
BodyArray
