Polarix/kicad_libs_append/3d_model/Dupont2.54mm_Male_Bent_5Pin.STEP

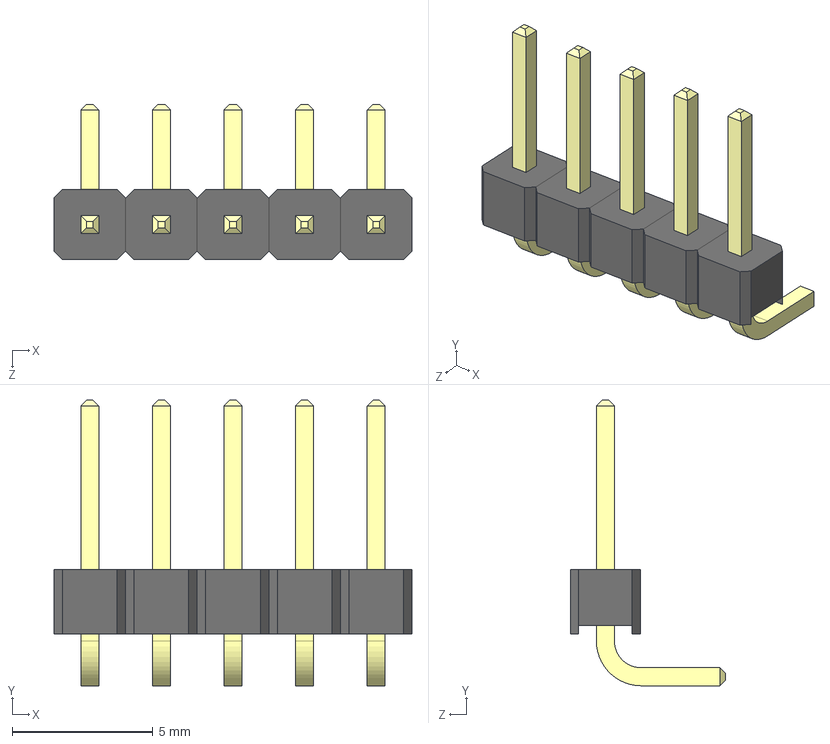
[picture p82: CAD file, 2025-03-25]
3d_model/Dupont2.54mm_Male_Bent_5Pin.STEP
12.7 x 10.1 x 5.52 mm
BodyArray
PinArray
