Polarix/kicad_libs_append/3d_model/Dupont2.54mm_Male_9Pin.STEP

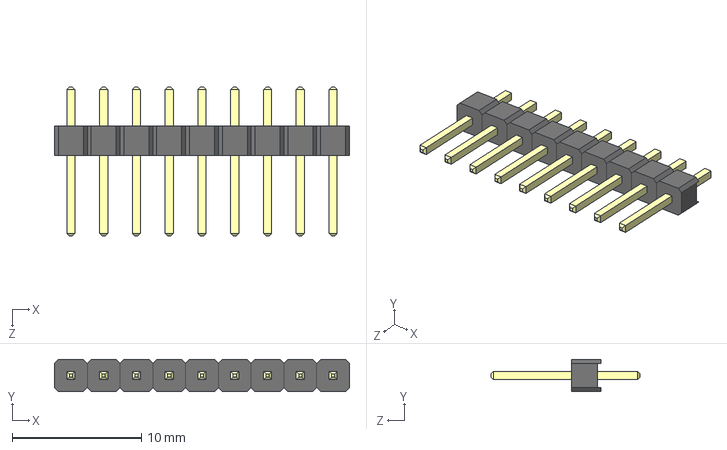
[picture p83: CAD file, 2025-03-25]
3d_model/Dupont2.54mm_Male_9Pin.STEP
22.9 x 2.49 x 11.5 mm
PinArray
BodyArray
