Polarix/kicad_libs_append/3d_model/Dupont2.54mm_Male_Bent_6Pin.STEP

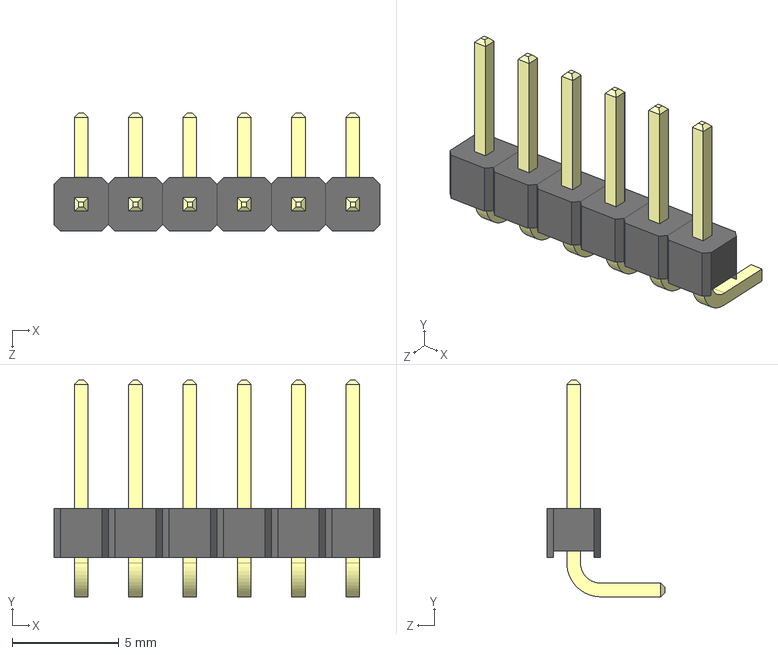
[picture p87: CAD file, 2025-03-25]
3d_model/Dupont2.54mm_Male_Bent_6Pin.STEP
15.2 x 10.1 x 5.52 mm
BodyArray
PinArray
