Polarix/kicad_libs_append/3d_model/Dupont2.54mm_Male_10Pin.STEP

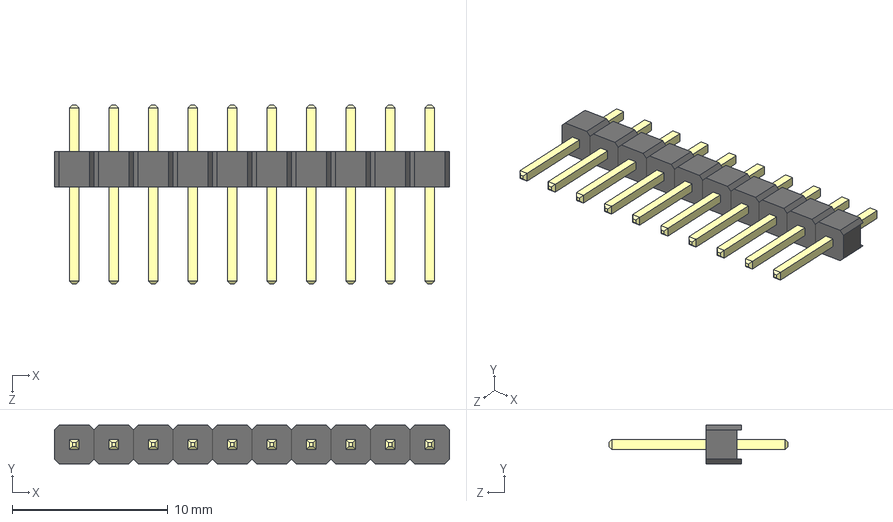
[picture p88: CAD file, 2025-03-25]
3d_model/Dupont2.54mm_Male_10Pin.STEP
25.4 x 2.49 x 11.5 mm
PinArray
BodyArray
