Polarix/kicad_libs_append/3d_model/Dupont2.54mm_Male_5Pin.STEP

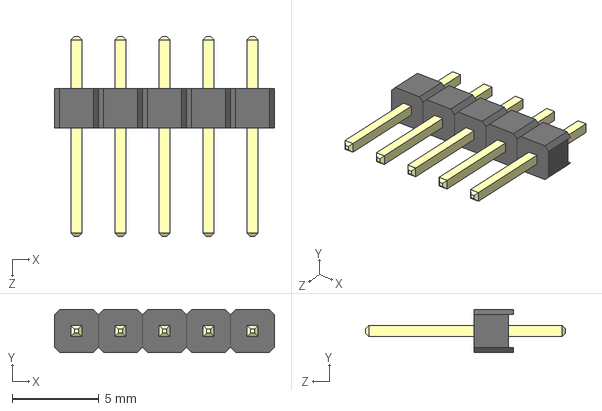
[picture p94: CAD file, 2025-03-25]
3d_model/Dupont2.54mm_Male_5Pin.STEP
12.7 x 2.49 x 11.5 mm
PinArray
BodyArray
