Polarix/kicad_libs_append/3d_model/FPC0.5mm_Filp_Horizontal_28P.stp

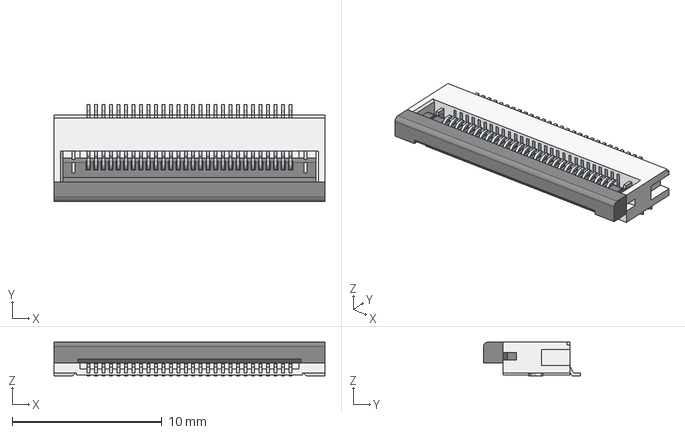
[picture p95: CAD file, 2025-03-25]
3d_model/FPC0.5mm_Filp_Horizontal_28P.stp
18.1 x 6.50 x 2.25 mm
