Polarix/kicad_libs_append/3d_model/FPC0.5mm_Filp_Horizontal_42P.stp

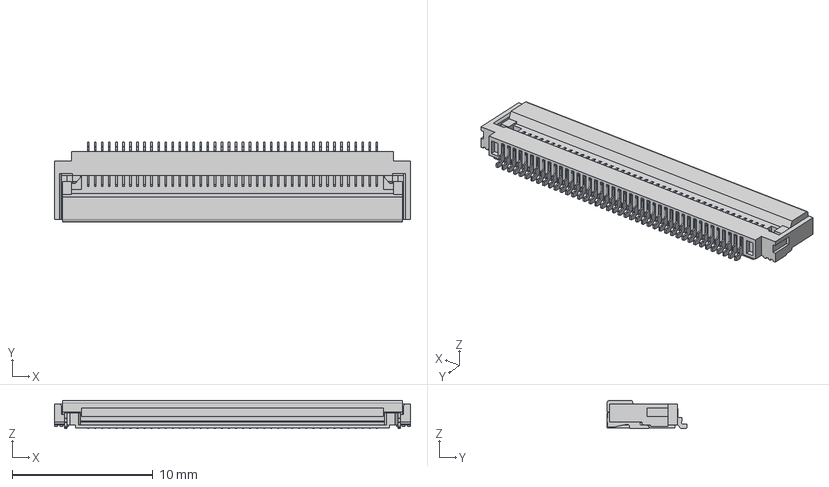
[picture p98: CAD file, 2025-03-25]
3d_model/FPC0.5mm_Filp_Horizontal_42P.stp
25.3 x 5.70 x 2.00 mm
