Polarix/kicad_libs_append/3d_model/Molex-43045_MX3.0_2×2P.stp

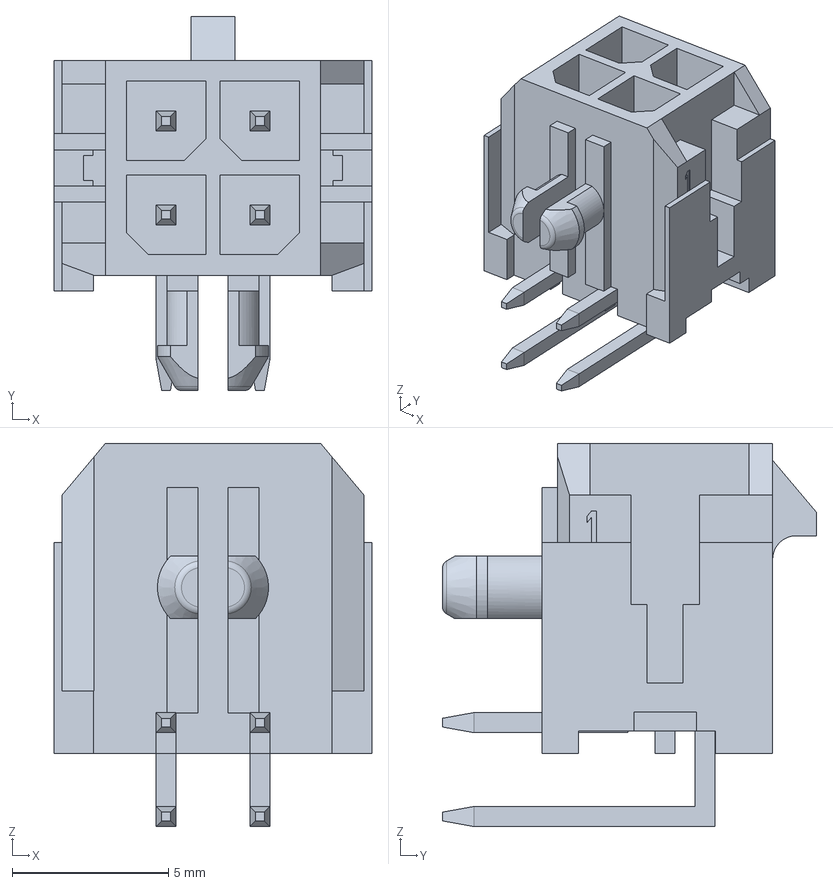
[picture p99: CAD file, 2025-03-21]
3d_model/Molex-43045_MX3.0_2×2P.stp
10.2 x 11.9 x 12.2 mm
