Polarix/kicad_libs_append/3d_model/XKB-7070-Z.stp

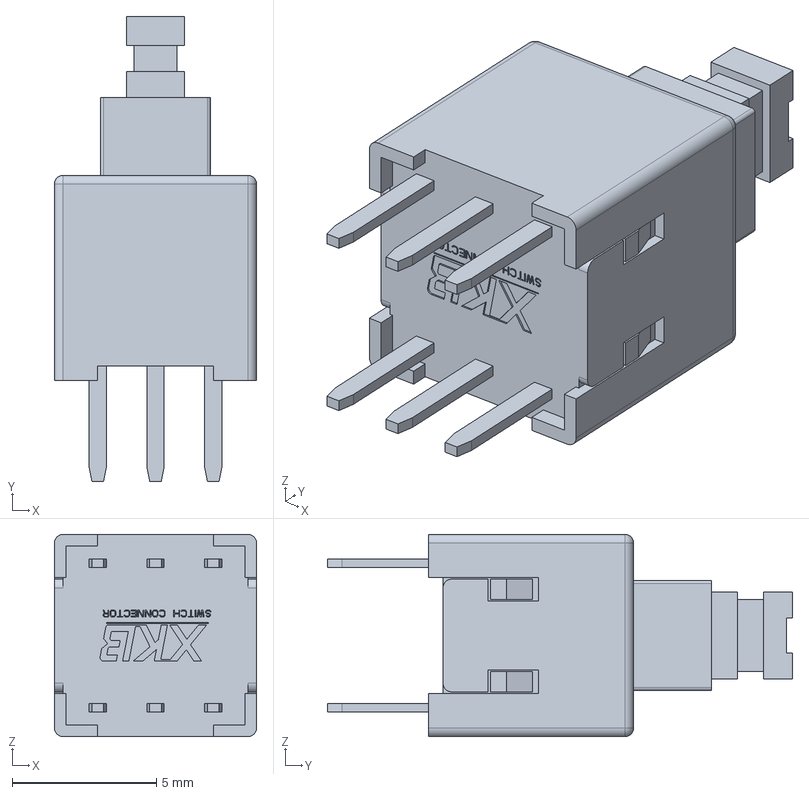
[picture p100: CAD file, 2025-03-17]
3d_model/XKB-7070-Z.stp
7.00 x 16.1 x 7.00 mm
