Polarix/kicad_libs_append/3d_model/XKB-8080-Z.stp

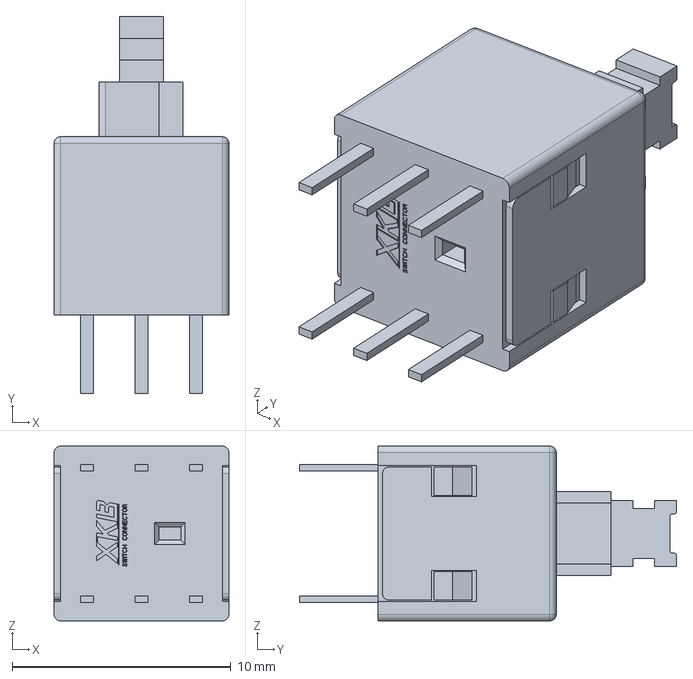
[picture p101: CAD file, 2025-03-17]
3d_model/XKB-8080-Z.stp
8.00 x 17.2 x 8.00 mm
