Polarix/kicad_libs_append/3d_model/XKB-5858-Z.stp

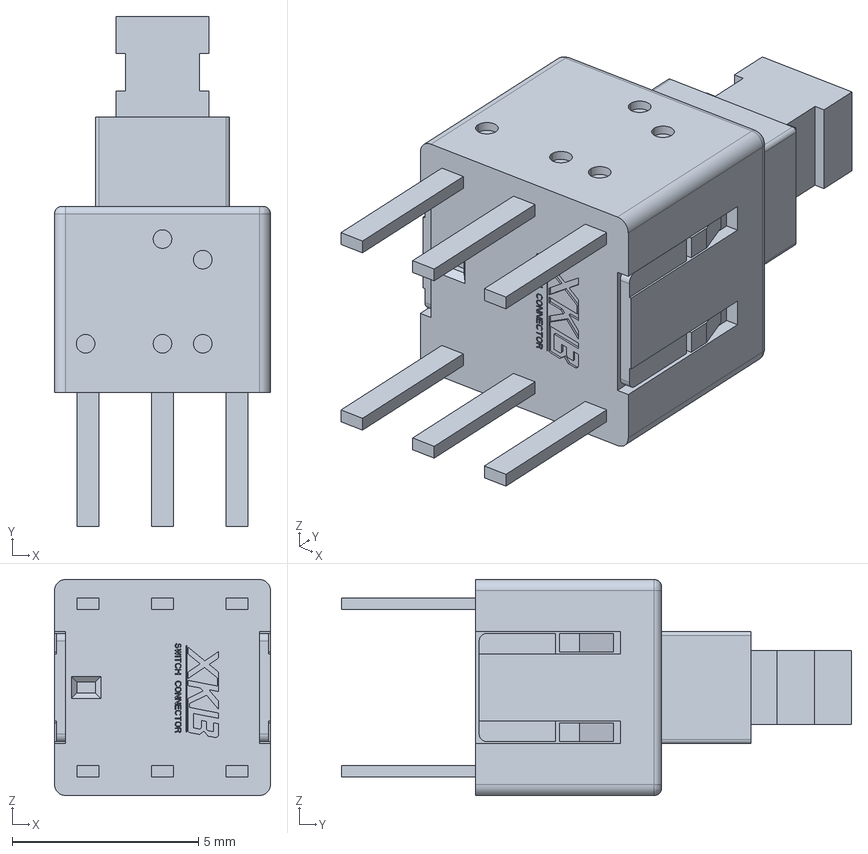
[picture p102: CAD file, 2025-03-17]
3d_model/XKB-5858-Z.stp
5.80 x 13.7 x 5.80 mm
