Polarix/kicad_libs_append/3d_model/XKB-8585-Z.stp

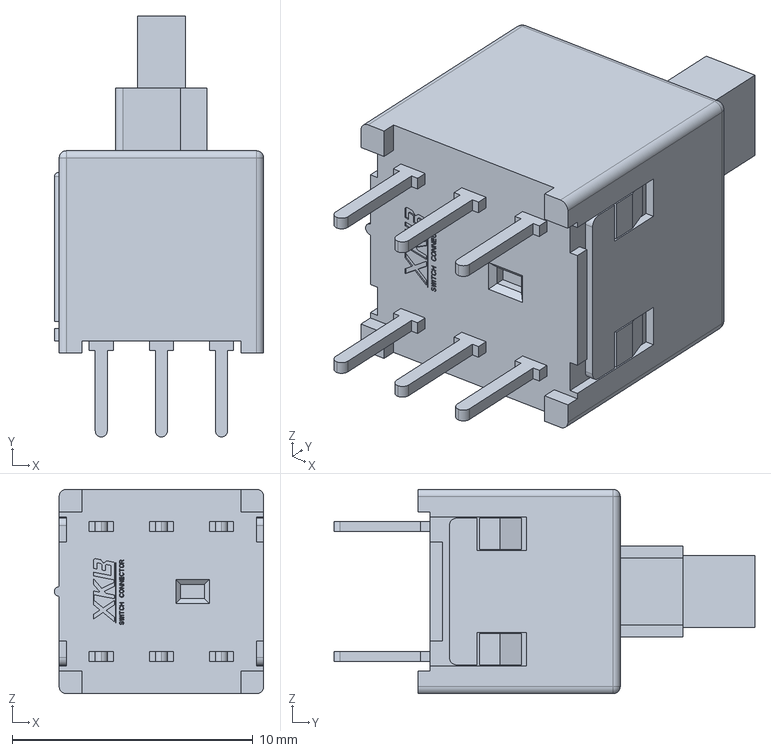
[picture p103: CAD file, 2025-03-17]
3d_model/XKB-8585-Z.stp
8.70 x 17.5 x 8.50 mm
