Polarix/kicad_libs_append/3d_model/B103_Potentiometer-3P.STEP

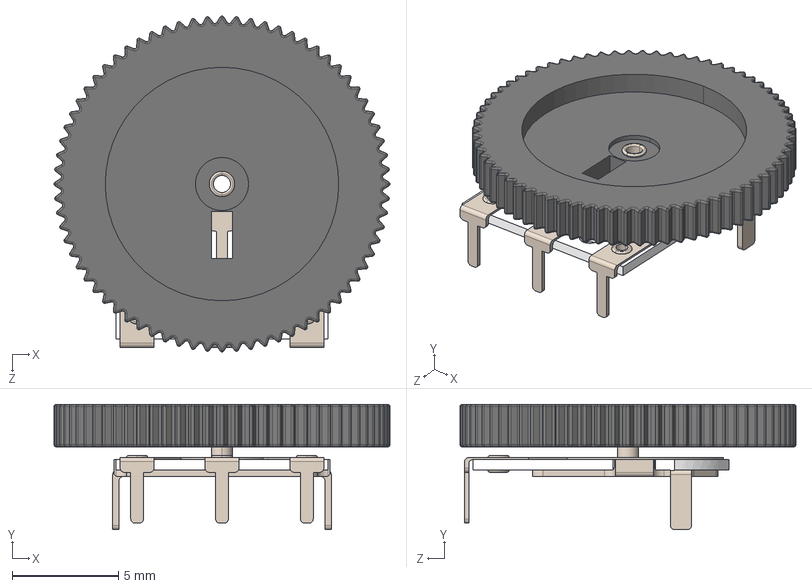
[picture p104: CAD file, 2025-03-11]
3d_model/B103_Potentiometer-3P.STEP
15.8 x 5.90 x 15.8 mm
base_默认
gear_默认
