Polarix/kicad_libs_append/3d_model/SKRPAC.STEP

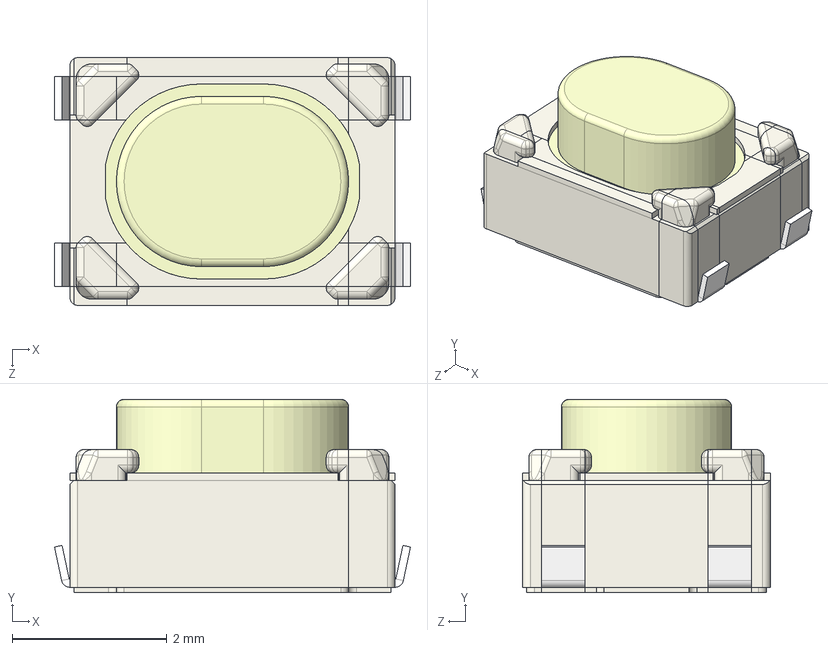
[picture p105: CAD file, 2025-01-26]
3d_model/SKRPAC.STEP
4.60 x 2.50 x 3.20 mm
