Polarix/kicad_libs_append/3d_model/SOP-8.STEP

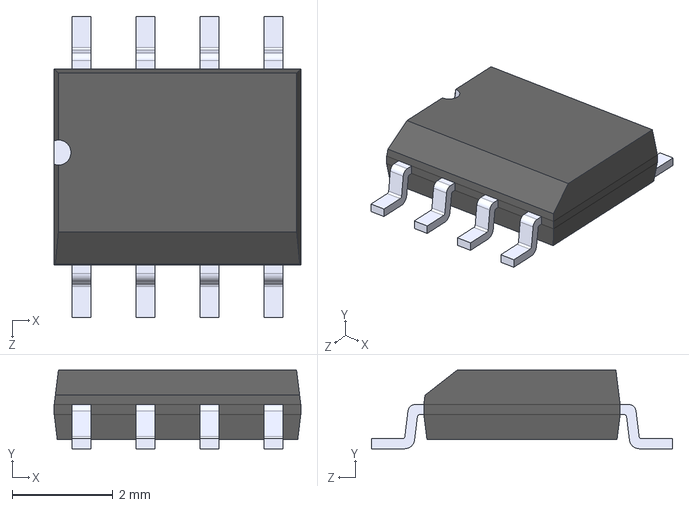
[picture p106: CAD file, 2025-01-24]
3d_model/SOP-8.STEP
4.90 x 1.56 x 5.98 mm
pin5to8_sop8 x 8
sop8_body
