Polarix/kicad_libs_append/3d_model/IPEX-V1.STEP

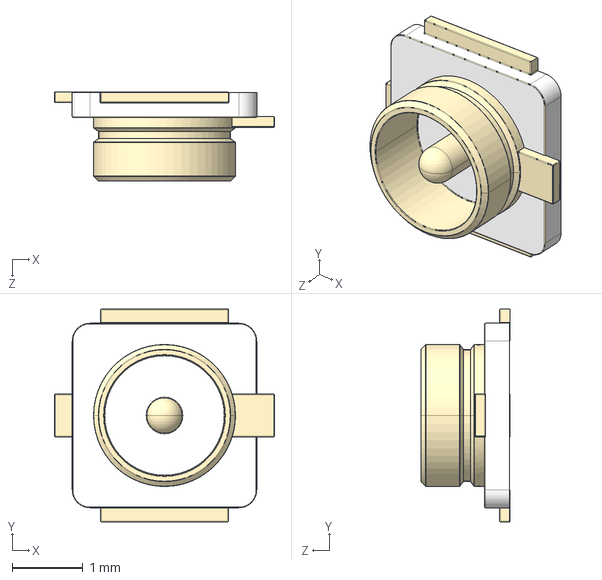
[picture p107: CAD file, 2025-01-24]
3d_model/IPEX-V1.STEP
3.10 x 3.00 x 1.26 mm
