Polarix/kicad_libs_append/3d_model/USB_Type-C_6P_PowerOnly_SMD.STEP

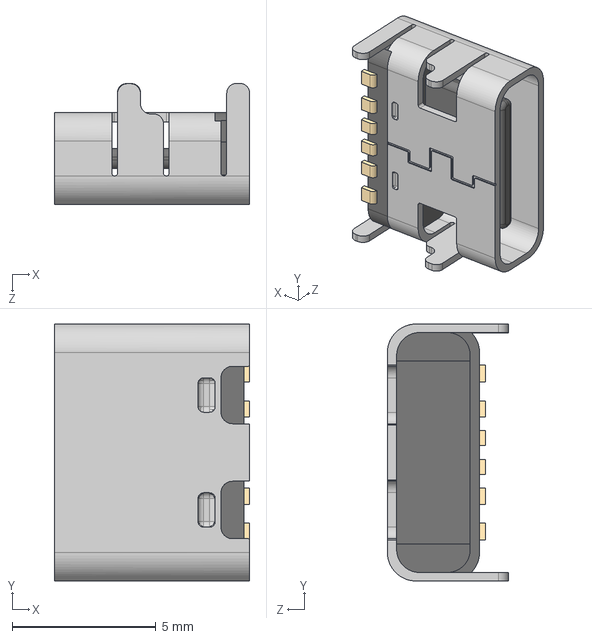
[picture p108: CAD file, 2024-10-22]
3d_model/USB_Type-C_6P_PowerOnly_SMD.STEP
6.80 x 8.94 x 4.22 mm
