Polarix/kicad_libs_append/3d_model/USB_Type-C_16P_HS_SMD.STEP

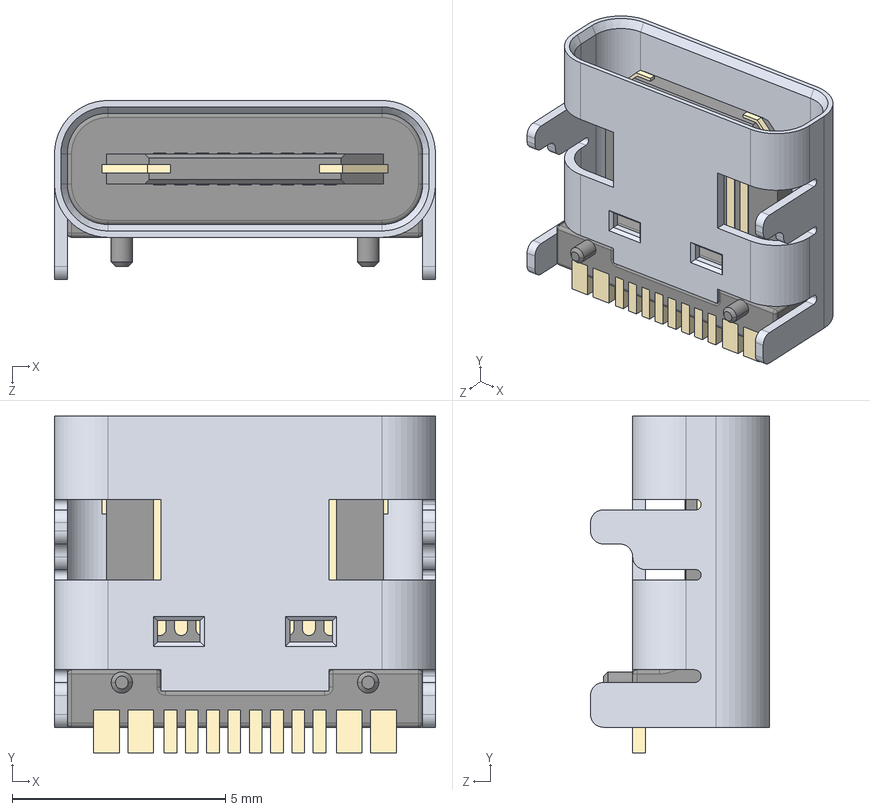
[picture p109: CAD file, 2024-10-22]
3d_model/USB_Type-C_16P_HS_SMD.STEP
8.94 x 7.90 x 4.20 mm
