Polarix/kicad_libs_append/(list of files, cad)

Other CAD files:
3d_model/MX1.25-4P_THT_V.stp
3d_model/MX1.25-4P_SMD_H.stp
3d_model/MX1.25-4P_THT_H.stp
3d_model/18650_SMD_Battery_Holder_x1.step
3d_model/18650_SMD_Battery_Holder_x2.STEP
