Polarix/kicad_libs_append/blocks/general/MCU low-level reset.kicad_block/MCU low-level reset.kicad_sch

## KiCad design blocks/general/MCU low-level reset.kicad_block/MCU low-level reset.kicad_sch (2025-06-18)

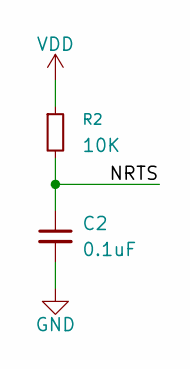
[picture p110: schematic MCU low-level reset.kicad_sch]

Parts:
C2: 0.1uF; C_0603_1608Metric
R2: 10K; R_0603_1608Metric

Connections:
GND: C2.2
NRTS: C2.1, R2.2
VDD: R2.1
