Polarix/kicad_libs_append/blocks/interface/UBS2.0 Type-C.kicad_block/UBS2.0 Type-C.kicad_sch

## KiCad design blocks/interface/UBS2.0 Type-C.kicad_block/UBS2.0 Type-C.kicad_sch (2025-04-03)

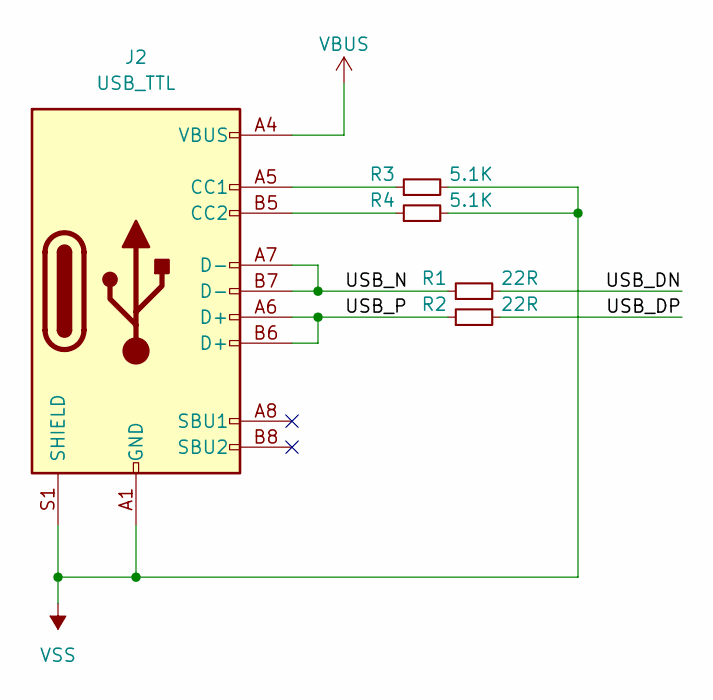
[picture p111: schematic UBS2.0 Type-C.kicad_sch]

Parts:
J2: USB_TTL; USB_C_Receptacle_HRO_TYPE-C-31-M-12
R1, R2: 22R; R_0603_1608Metric
R3, R4: 5.1K; R_0603_1608Metric

Connections:
unnamed: J2.A5 (CC1), R3.1
unnamed: J2.B5 (CC2), R4.1
USB_DN: R1.2
USB_DP: R2.2
USB_N: J2.A7 (D-), J2.B7 (D-), R1.1
USB_P: J2.A6 (D+), J2.B6 (D+), R2.1
VBUS: J2.A4 (VBUS), J2.A9 (VBUS), J2.B4 (VBUS), J2.B9 (VBUS)
VSS: J2.A1 (GND), J2.A12 (GND), J2.B1 (GND), J2.B12 (GND), J2.S1 (SHIELD), R3.2, R4.2
