Polarix/kicad_libs_append/blocks/interface/USB Type-C Power-only.kicad_block/USB Type-C Power-only.kicad_sch

## KiCad design blocks/interface/USB Type-C Power-only.kicad_block/USB Type-C Power-only.kicad_sch (2025-03-31)

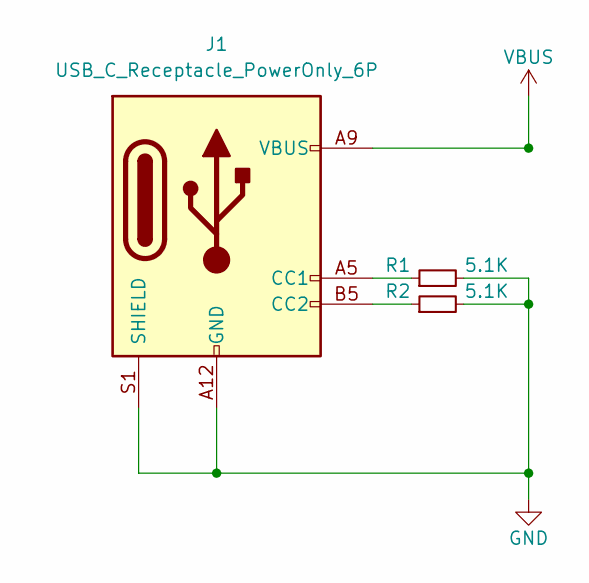
[picture p112: schematic USB Type-C Power-only.kicad_sch]

Parts:
J1: USB_C_Receptacle_PowerOnly_6P; USB_C_6P_PowerOnly
R1, R2: 5.1K; R_0603_1608Metric

Connections:
GND: J1.A12 (GND), J1.B12 (GND), J1.S1 (SHIELD), R1.2, R2.2
unnamed: J1.A5 (CC1), R1.1
unnamed: J1.B5 (CC2), R2.1
VBUS: J1.A9 (VBUS), J1.B9 (VBUS)
