Polarix/kicad_libs_append/blocks/motor_driver/AT8236 Motor Driver.kicad_block/AT8236 Motor Driver.kicad_sch

## KiCad design blocks/motor_driver/AT8236 Motor Driver.kicad_block/AT8236 Motor Driver.kicad_sch (2025-03-31)

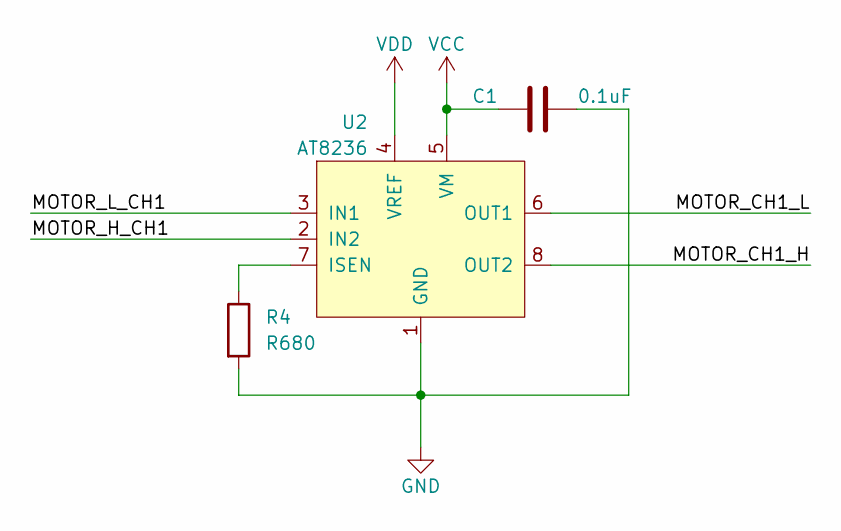
[picture p113: schematic AT8236 Motor Driver.kicad_sch]

Parts:
C1: 0.1uF; C_0603_1608Metric
R4: R680; R_1210_3225Metric
U2: AT8236; SOIC-8-1EP_3.9x4.9mm_P1.27mm_EP2.41x3.3mm_ThermalVias

Connections:
GND: C1.2, R4.2, U2.1 (GND), U2.9 (GND)
MOTOR_CH1_H: U2.8 (OUT2)
MOTOR_CH1_L: U2.6 (OUT1)
MOTOR_H_CH1: U2.2 (IN2)
MOTOR_L_CH1: U2.3 (IN1)
unnamed: R4.1, U2.7 (ISEN)
VCC: C1.1, U2.5 (VM)
VDD: U2.4 (VREF)
