Polarix/kicad_libs_append/blocks/power/JW5033 Buck Model.kicad_block/JW5033 Buck Model.kicad_sch

## KiCad design blocks/power/JW5033 Buck Model.kicad_block/JW5033 Buck Model.kicad_sch (2025-05-09)

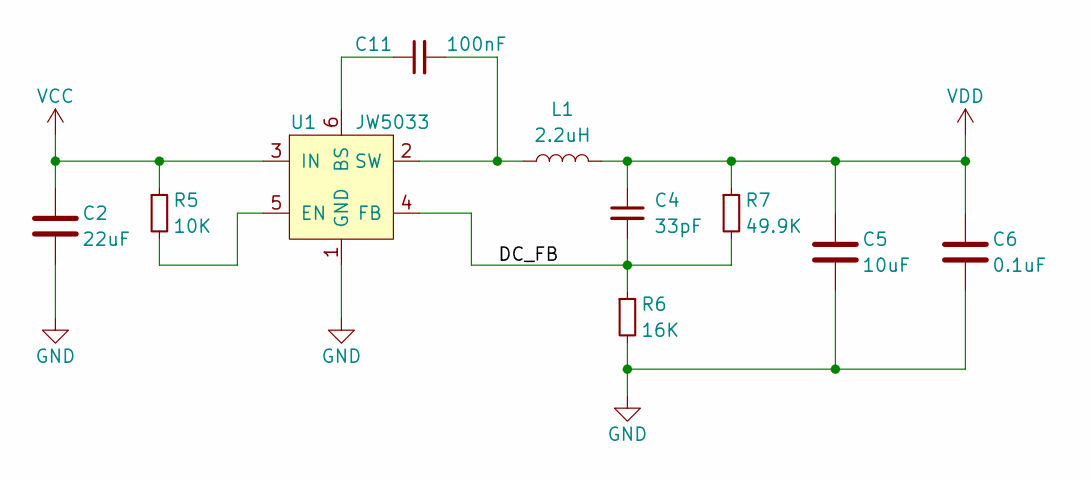
[picture p114: schematic JW5033 Buck Model.kicad_sch]

Parts:
C2: 22uF; C_0805_2012Metric
C4: 33pF; C_0201_0603Metric
C5: 10uF; C_0805_2012Metric
C6: 0.1uF; C_0805_2012Metric
C11: 100nF
L1: 2.2uH; L_Cenker_CKCS3012
R5: 10K; R_0603_1608Metric
R6: 16K; R_0603_1608Metric
R7: 49.9K; R_0603_1608Metric
U1: JW5033

Connections:
DC_FB: C4.2, R6.1, R7.2, U1.4 (FB)
GND: C2.2, C5.2, C6.2, R6.2, U1.1 (GND)
unnamed: C11.1, U1.6 (BS)
unnamed: C11.2, L1.1, U1.2 (SW)
unnamed: R5.2, U1.5 (EN)
VCC: C2.1, R5.1, U1.3 (IN)
VDD: C4.1, C5.1, C6.1, L1.2, R7.1
