Polarix/kicad_libs_append/blocks/power/SX1308 Boost Model.kicad_block/SX1308 Boost Model.kicad_sch

## KiCad design blocks/power/SX1308 Boost Model.kicad_block/SX1308 Boost Model.kicad_sch (2025-06-07)

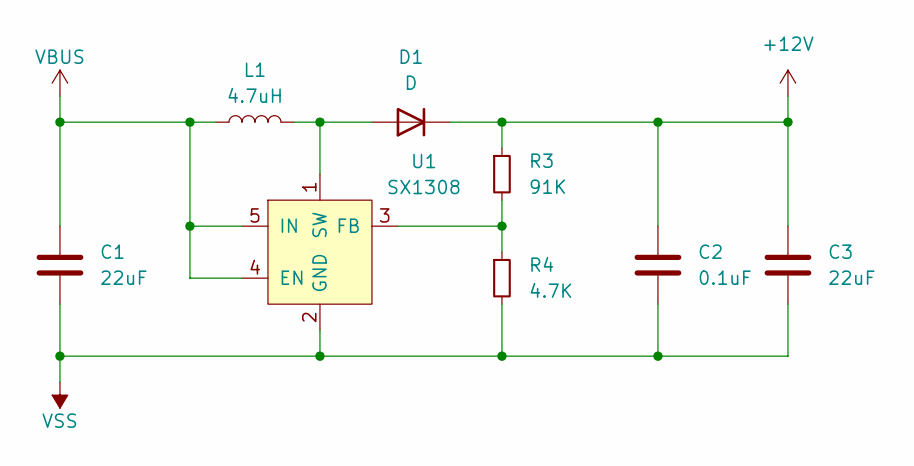
[picture p115: schematic SX1308 Boost Model.kicad_sch]

Parts:
C1, C3: 22uF; C_1206_3216Metric
C2: 0.1uF; C_1206_3216Metric
D1: D; D_SMB
L1: 4.7uH; L_Cenker_CKCS4020
R3: 91K; R_0603_1608Metric
R4: 4.7K; R_0603_1608Metric
U1: SX1308; SOT-23-6

Connections:
+12V: C2.1, C3.1, D1.1 (K), R3.1
unnamed: D1.2 (A), L1.2, U1.1 (SW)
unnamed: R3.2, R4.1, U1.3 (FB)
VBUS: C1.1, L1.1, U1.4 (EN), U1.5 (IN)
VSS: C1.2, C2.2, C3.2, R4.2, U1.2 (GND)
