Polarix/kicad_libs_append/blocks/power/SX2106 Buck Model.kicad_block/SX2106 Buck Model.kicad_sch

## KiCad design blocks/power/SX2106 Buck Model.kicad_block/SX2106 Buck Model.kicad_sch (2025-03-31)

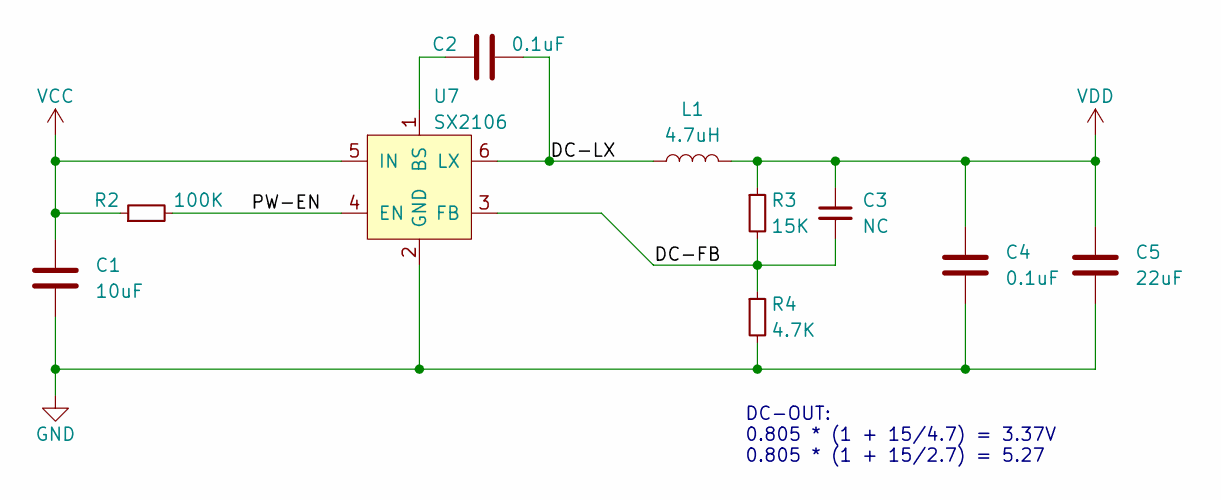
[picture p116: schematic SX2106 Buck Model.kicad_sch]

Parts:
C1: 10uF; C_0805_2012Metric
C2, C4: 0.1uF; C_0805_2012Metric
C3: NC; C_0603_1608Metric
C5: 22uF; C_0805_2012Metric
L1: 4.7uH; L_Cenker_CKCS5020
R2: 100K; R_0603_1608Metric
R3: 15K; R_0603_1608Metric
R4: 4.7K; R_0603_1608Metric
U7: SX2106; SOT-23-6_Handsoldering

Connections:
DC-FB: C3.2, R3.2, R4.1, U7.3 (FB)
DC-LX: C2.2, L1.1, U7.6 (LX)
GND: C1.2, C4.2, C5.2, R4.2, U7.2 (GND)
unnamed: C2.1, U7.1 (BS)
PW-EN: R2.2, U7.4 (EN)
VCC: C1.1, R2.1, U7.5 (IN)
VDD: C3.1, C4.1, C5.1, L1.2, R3.1

Notes on the sheet:
DC-OUT: 0.805 * (1 + 15/4.7) = 3.37V 0.805 * (1 + 15/2.7) = 5.27
