Polarix/kicad_libs_append/(commit log)

2023-03-14 补充忽略规则
2023-03-14 添加贴片天线的封装
2023-03-15 增加电源符号补充
2023-03-15 补充IPEX天线插座封装
2023-06-01 增加天线符号库
2023-06-01 增加普冉PY32系列单片机符号库
2023-06-06 创建通用元件库
2023-06-06 创建电源芯片库
2023-06-06 创建MCU库
2023-06-06 补充STM32F030C8
    补充STM32F030F4
2023-09-05 增加多种MCU符号库
2024-09-30 Delete symbols/general.kicad_sym
    移除有冲突的文件
2024-09-30 添加新符号
2024-10-09 新增升压芯片SX1308的符号，电源芯片库重命名
2024-10-09 整合普冉PY32F002/003系列单片机符号
2024-10-09 整理电源IC符号
2024-10-09 移动MCU符号库的路径
2024-10-09 移除空文件夹
2024-10-09 修正FP6291升压IC的名称错误
2024-10-16 添加航顺HK32F030MF4P6单片机的符号
2024-10-16 修正PY32F002A芯片的描述信息
2024-10-16 添加2.54mm 7P端子符号
2024-10-16 更新0.5mm翻盖式FPC插座4p-24p封装
2024-10-17 移动屏幕封装库路径
2024-10-17 移除无用的电源符号库
2024-10-17 删除无用文件
2024-10-17 添加器件封装
2024-10-18 添加EG1151升降压IC符号
2024-10-18 添加SC8701升降压IC符号
2024-10-18 修正SC8701符号的标注
2024-10-19 整理天线封装和IPEX插座封装
2024-10-19 移除重复的无用文件
2024-10-19 将general库临时移动到deprecated目录中等待整理
2024-10-19 添加FPC接口和2.54mm杜邦接口的封装
2024-10-19 添加JST1.25mm插座封装
2024-10-19 移除无效的旧封装
2024-10-19 整理按键封装
2024-10-19 创建模块封装目录和3D模型目录
2024-10-19 移除重复的屏幕符号库
2024-10-19 整理USB连接器封装
2024-10-19 更新2.45mm接线端子的轮廓定义
2024-10-19 添加连接器符号库
2024-10-19 更新屏幕符号
2024-10-19 统一文件名大小写
2024-10-19 整理电机驱动IC符号库
2024-10-22 增加模块符号和封装库
2024-10-22 创建特殊封装库
2024-10-22 整理TF卡槽和部分连接器封装
2024-10-22 移除无用封装，更新开关封装库路径名
2024-10-22 整理封装
2024-10-22 更新readme
2024-10-22 移除重复的JST连接器封装
2024-10-22 补充两种USB接口的3D模型
    [USB_Type-C_16P_HS_SMD.STEP, USB_Type-C_6P_PowerOnly_SMD.STEP]
2024-10-23 增加MUN3CAD01和EM3485电源模块的符号和封装
2024-10-23 增加TF卡外形连接器的符号和封装
2024-10-23 更新TF卡压弹式插槽和翻盖式插槽封装
2024-10-23 增加WSON烧录座封装
2024-10-23 更新翻盖TF卡座信息
2024-10-23 更新WSON8烧录座的封装命名
2024-10-24 更新TF卡引脚符号和定义和封装
2024-10-24 更新TF卡外形封装的原点
2024-10-24 更新TF卡封装的外形错误
2024-10-24 增加接口芯片的符号库
2024-10-24 整理归并MPS电源IC符号
2024-10-24 增加RY8310电源芯片符号
2024-10-28 增加焊盘、螺孔、跳线封装库
2024-10-28 更新GL823K读卡器芯片的引脚特性参数
2024-10-28 更新GL823K的关键字描述
2024-10-28 更新压弹式TF卡座轮廓信息
2024-10-28 移除无用的符号定义
2024-10-30 更新WSON-8烧录座封装
2024-10-30 更新沁恒CH系列USB串口转换芯片符号，增加CH334/335 USB-HUB芯片符号
2024-10-30 更新封装描述信息
2024-10-30 增加两种M2孔径的PCB螺柱封装
2024-10-30 更新螺柱封装的名称
2024-11-03 修正WSON-8烧录座的封装尺寸
2024-11-03 更新0.5mm间距FPC插座封装的轮廓
2024-11-03 更新TF卡触点封装
2024-11-04 添加EC04微型编码器封装
2024-11-06 更新EC04贴片编码器封装
2024-11-15 补充TS-10B位置检测开关封装
2024-11-15 添加一种 翻盖式WSON8芯片测试坐封装
2024-11-15 修正TS-10B位置检测开关的定位孔尺寸和位置
2024-11-17 补充四脚MX2.54带锁杜邦插座封装
2024-11-17 移除无用的STM32G单片机库
2024-11-17 更新说明文件
2024-11-17 符号库中增加临时器件库方便管理
2024-11-17 增加摇杆符号
2024-11-17 增加按引脚布局描述的ESP32-S3符号
2024-11-17 整理共通符号
2024-11-17 增加EC0601 4脚编码器的符号和封装
2024-11-18 增加MX2.0插座插件封装
2024-11-22 增加山谷道板对板连接器的封装
2024-11-23 增加IP2312充电芯片的符号
2024-11-23 调整IP2312的符号引脚排布
2024-11-23 增加KFC-V-501微动开关的封装
2024-11-24 订正SGD板连接器的引脚排布，改为公母互为镜像
2024-11-27 增加射频器件库
2024-11-27 移除无用的重复器件
2024-11-27 增加传感器器件库
2024-11-27 整理电源IC器件库
2024-11-30 整理补充LM66200理想二极管控制器符号
2024-12-14 补充GH1.25卧贴插座封装
2024-12-14 更新IP2312充电芯片符号
2024-12-18 添加RTC时钟芯片符号库
2024-12-18 增加库文件配置参考
2024-12-18 移动SPG30传感器封装
2024-12-18 更新描述文件的内容
2024-12-18 添加电路板模块封装库和符号库
2024-12-18 补充自制STM32核心板符号和封装
2024-12-18 移除不再使用的符号库
2024-12-18 更新库配置文件
2024-12-18 更新描述文件
2024-12-23 增加E5/E8编码器封装
2024-12-23 增加一个LQFP-48和QFN-48的联合封装
2024-12-30 增加电脑主板前置USB2.0接口的符号和封装
2024-12-30 补充2x15P双排针符号
2024-12-30 增加2*15P 2.54mm双排针封装
2024-12-31 增加M.2金手指封装
2024-12-31 更新MX2.54带锁杜邦插座封装
2025-01-03 增加2.4G前端芯片RFX2401C/GC1101的符号定义
2025-01-04 移除不必要的封装
2025-01-04 补充AON7401 MOS管的符号和封装
2025-01-04 修正HUSB238芯片的符号
2025-01-04 补充2×8排针的符号和封装
2025-01-04 修正错误的连接器符号
2025-01-04 补充IP2315充电芯片符号
2025-01-05 增加ST32F403ACCT7单片机符号
2025-01-05 增加JST1.25 2P卧贴查做封装
2025-01-05 更新SD2077 RTC芯片符号
2025-01-11 更新2×4和2×5针2.54间距排针封装
2025-01-11 更新2×4和2×5针2.54间距排针符号
2025-01-15 添加ETA6002充电芯片的符号
2025-01-15 添加IP2333充电芯片符号
2025-01-15 添加IP2331充电芯片的符号
2025-01-16 更新2×4P和2×5P2.54端子封装
2025-01-17 增加E103-RTL8811CU WIFI模块的符号和封装
2025-01-17 修正E103-RTL8811CU WIFI模块的电源引脚类型
2025-01-20 更新PY32F002A的符号
2025-01-20 更新Ci24R1射频芯片的符号
2025-01-20 更新MSK12C01贴片开关封装
2025-01-20 更新IPEX插座符号和封装
2025-01-23 增加AT32F435ACCT7符号
2025-01-23 更新IPEX1代插座封装，增加IPEX4代插座封装
2025-01-24 增加PL5501电源芯片符号
2025-01-24 增加SC8903电源芯片符号
2025-01-24 增加IPEX插座和SOP-8芯片的封装模型
    [IPEX-V1.STEP, SOP-8.STEP]
2025-01-24 修正MSK12C01拨动开关封装
2025-01-24 添加一种0.87寸12832 OLED屏幕模块的封装
2025-01-25 增加一个兼容STM32F103C8/030C8/401CC等48脚MCU的符号
2025-01-25 更新F103类MCU符号引脚排布
2025-01-25 增加4.5mm M2螺丝孔和1mm独立焊盘封装
2025-01-25 增加TS-1070贴片按键的3D模型
    [SKRPAC.STEP]
2025-01-25 增加M2螺丝孔封装的焊盘名称
2025-02-03 增加理想二极管MX5052和MX5050T的符号定义
2025-02-03 修正MX5052符号的参数
2025-02-05 增加PH2.0直针2/3/4P插座封装
2025-02-05 更新PH2.0直针插座的描述信息
2025-02-05 增加PH2.0弯针4针插座封装
2025-02-08 更新E5A1/E8H6/E8E7编码器封装和信息
2025-02-08 添加E5E8/E8H7编码器封装
2025-02-10 更新Readme文件
2025-02-28 增加AT32F413KBU7单片机符号
2025-02-28 更新AT32F435CCT7单片机符号
2025-02-28 增加APM32F003单片机符号
2025-03-03 增加电机驱动芯片RZ7899符号
2025-03-05 添加3脚和5脚的拨轮电位器封装
2025-03-05 增加MSK12C01和MSK13C010拨动开关的封装
2025-03-10 增加CH440四路二选一模拟开关符号
2025-03-11 增加B103电位器封装的3D模型
    [B103_Potentiometer-3P.STEP]
2025-03-11 增加摇杆和电位器的封装仓库
2025-03-11 更新封装库配置模板
2025-03-11 统一封装库中路径变量的使用
2025-03-12 将手柄、电位器库合并到按钮开关库
2025-03-12 更新符号库配置文件
2025-03-12 更新PSP游戏机遥感封装的机械孔位置错误
2025-03-15 增加AT1106和AT8236电机驱动芯片的符号
2025-03-15 增加CH442E复用器符号
2025-03-15 修正2x5P双排针的符号错误
2025-03-15 增加MSK12C02拨动开关封装
2025-03-15 增加CH443K符号
2025-03-15 增加XKB-5858/7070/8080/8585自锁开关的封装
    [XKB-5858-Z.stp, XKB-7070-Z.stp, XKB-8080-Z.stp, XKB-8585-Z.stp]
2025-03-17 更新CH443K的封装
2025-03-17 更换PSP摇杆封装的机械孔与焊盘尺寸
2025-03-18 增加MS2108视频采集接口IC的符号
2025-03-21 增加2×2P连接器符号
2025-03-21 增加MX3.0 2×2P连接器封装
    [Molex-43045_MX3.0_2×2P.stp]
2025-03-25 增加40P和42P连接器符号及FPC连接器封装
    [FPC0.5mm_Filp_Horizontal_40P.stp, FPC0.5mm_Filp_Horizontal_42P.stp]
2025-03-25 增加28P和30P连接器的符号和对应的FPC连接器封装
    [FPC0.5mm_Filp_Horizontal_28P.stp, FPC0.5mm_Filp_Horizontal_30P.stp]
2025-03-25 修正MX3.0 2×2P插座的封装
2025-03-25 增加2.54mm间距的杜邦直排针和弯排针3D模型
    [Dupont2.54mm_Male_10Pin.STEP, Dupont2.54mm_Male_1Pin.STEP, Dupont2.54mm_Male_2Pin.STEP, Dupont2.54mm_Male_3Pin.STEP, Dupont2.54mm_Male_40Pin.STEP, Dupont2.54mm_Male_4Pin.STEP, Dupont2.54mm_Male_5Pin.STEP, Dupont2.54mm_Male_6Pin.STEP]
2025-03-26 增加RPI-221光电对射开关的封装和3D模型
    [RPI-221.STEP]
2025-03-26 增加RPI-221光电对射开关的封装
2025-03-26 增加RPI-243光电对射开关的封装和3D模型
    [RPI-243.stp]
2025-03-26 增加RPI-441C1光电对射开关的封装和3D模型
    [RPI-441C1.stp]
2025-03-26 增加光电对射开关的符号
2025-03-27 增加PH2.0mm接口8P/10P的封装
2025-03-27 增加用于磁编码器的特殊SOIC8封装
2025-03-27 增加CH444P多路复用器的符号
2025-03-31 增加KiCAD9的电路图快库
    [AT8236 Motor Driver.json, AT8236 Motor Driver.kicad_sch, SX2106 Buck Model.kicad_sch, USB Type-C Power-only.kicad_sch]
2025-03-31 更新米奥数文件，补充图块库的相关说明
2025-04-02 更新按钮的3d模型
    [4mm_SMD_Button.STEP, TS-1010-XA_SMD_Button.stp, TS-1010B_SMD_Button.stp, TS-1070_SMD_Button.stp, TS-1185_SMD_Button.stp]
2025-04-03 增加PCA9544/9548A IIC接口复用IC的符号
2025-04-03 增加DW05DLC TVS二极管符号
2025-04-03 增加USB2.0 Type-C接口的电路图块
    [UBS2.0 Type-C.kicad_sch]
2025-04-03 更新DW05DLC TVS二极管符号
2025-04-03 增加AT32F421C8T7单片机的符号
2025-04-03 更新AT32F421C8T7的符号，修正错误的IO管脚
2025-04-11 修正MS2108的错误封装
2025-04-19 更新CH342F串口芯片的符号
2025-04-19 增加2×3针2.54mm间距排针封装
2025-04-19 更新CH217芯片的符号
2025-04-19 增加1.5mm螺丝孔封装
2025-04-19 增加BV05C TVS二极管符号
2025-04-25 修正2.54mm 2×8端子封装的尺寸错误
2025-04-25 更新USB插座的封装信息
2025-04-25 更新描述
2025-05-08 增加AT32F421G和AT32F25F单片机的符号
2025-05-08 增加AT32L021FxP7单片机的符号
2025-05-09 增加AT32F421FxP7单片机符号
2025-05-09 增加JW5033 Buck电路模块
    [JW5033 Buck Model.kicad_sch]
2025-05-14 增加SII9022视频接口芯片的符号
2025-05-15 修正FPC插座耳座焊盘的轻微偏移
2025-05-15 修正6PUSB电源插座的封装类型错误
2025-05-15 增加MY-RGB2HDMI模块的符号和封装
2025-05-15 更新sii9022A接口芯片的符号名称
2025-05-15 增加HD50015C40屏幕的接口符号
2025-05-22 增加NF-05射频模块符号
2025-05-22 增加NF-05射频模块封装
2025-05-22 增加中科世为RGB采集模块接口封装
2025-05-22 增加反序的0.5mm FPC-40P插座封装
2025-05-22 增加安信可NF-03模块的符号，修正NF-05模块的错误描述
2025-05-27 增加SSD212的符号
2025-05-27 增加2.4G射频模块的符号
2025-05-27 增加几种2.4G射频模块封装
2025-05-28 增加2-9针PH2.0卧贴插座的3D模型
    [PH2.0-2P_WB.STEP, PH2.0-3P_WB.STEP, PH2.0-4P_WB.STEP, PH2_0-5P_WB.STEP, PH2_0-6P_WB.STEP, PH2_0-7P_WB.STEP, PH2_0-8P_WB.STEP, PH2_0-9P_WB.STEP]
2025-05-28 增加4P和8P的PH2.0插座封装
2025-05-30 增加39E/49E/59E霍尔传感器符号
2025-06-05 添加0.5mmFPC插座4-10P兼容封装
2025-06-05 增加正点原子RGB转HDMI模块符号
2025-06-06 增加3313J和3314J电位器的符号和封装
    [Pot-3313J-1.STEP, Pot-3313J-2.STEP, Pot-3314J.stp]
2025-06-06 增加光电对管开关的槽宽标记
2025-06-07 增加SX1308升压电路图块
    [SX1308 Boost Model.kicad_sch]
2025-06-07 增加计算文件目录，增加描述文件的相关内容。
2025-06-12 修正RPI系列光电开关的引脚编号错误
2025-06-12 更新ETA6002符号的功率地引脚
2025-06-13 增加AT32F435RMT7的符号定义
2025-06-13 增加AT32F435VMT7的符号定义
2025-06-16 增加CH32V203C8的符号
2025-06-16 修正CH32V303C8的符号
2025-06-16 更新CH32V30x系列MCU的符号
2025-06-16 增加EG2131栅极驱动器的符号
2025-06-18 修正RT8059电源芯片的符号
2025-06-18 增加RY8130稳压器的计算数据文件
2025-06-18 增加通用原理图图块库
    [MCU low-level reset.kicad_sch]
2025-07-20 更新RTL8811CU模块的封装，修正引脚间距错误
2025-07-24 增加0.78英寸OLED屏幕封装
2025-07-24 更新0.78寸屏幕的封装描述
2025-07-24 增加0.78寸屏幕的焊盘封装
2025-07-24 增加0.78寸OLED屏幕符号
2025-07-24 更新0.78寸屏幕焊盘封装的丝印层错误
2025-08-07 增加TPS61040升压IC的计算数据
2025-08-07 修正0.78寸OLED的封装外形
2025-08-08 增加乐鑫ESP32-C5开发板的符号和封装
2025-08-12 增加TTC鼠标编码器封装
2025-08-16 增加LuckFox-Pico-Zero核心板的符号和封装
2025-08-16 增加金逸晨1.47寸带触控16P屏幕符号和封装
2025-08-29 更新1.14寸插接TFT屏幕的封装和3D模型
2025-08-29 增加STM32F030F4核心板的符号
2025-08-29 增加STM32F030F4核心板的封装
2025-08-29 增加SPI接口的压弹式TF卡插槽图块
    [TFCard SPI.kicad_sch]
2025-08-30 更新JST1.25贴片插座的封装
2025-09-01 增加ATD5984步进电机驱动器符号
2025-09-01 更新ATD5984步进电机驱动器的符号定义
2025-09-01 增加A4988步进电机驱动芯片符号
2025-09-03 增加11针和12针的1.27间距和2.54间距排针封装
2025-09-03 增加HT75xx系列SOT-23封装的符号
2025-09-03 修正RT8059的符号错误
2025-09-03 增加RT8059的稳压器计算参数文件
2025-09-03 更新稳压器计算数据文件
2025-09-04 增加MSK/MSKT贴片开关封装及部分3D模型
    [MSK-12C01.STEP, MSK-12C02.STEP]
2025-09-04 增加JTAG10/14/20P连接器符号定义
2025-09-12 增加2×12p双排针符号与封装
2025-09-13 增加8通道2.54mm舵机端子封装
2025-11-07 增加JST2.54贴片插座的封装
2025-11-07 增加MP4420电源芯片的符号
2025-11-07 整合DC-DC的计算数据文件
2025-11-20 增加部分平芯微过压过流保护IC的符号
2025-11-21 增加GL3224读卡器IC的符号
2025-11-21 修改48P的GL3224符号
2025-12-02 增加MSM261S3526Z0CM数字麦克风的符号和封装模型
    [MSM261S3526Z0CM.STEP]
2025-12-02 修改ATD5984步进驱动器符号的引脚排布
2025-12-08 修改敏芯微MSM261S3526Z0CM数字麦克风的符号名称
2025-12-08 为MSM261S3526Z0CM和INMP441增加封装数据
2025-12-29 增加PW6606快充受电IC和CPC-8封装
2026-01-05 添加SIT3232E收发器IC的符号
2026-01-26 增加步进电机驱动器MS32006和MS41929的符号
2026-01-27 补充RV09电位器的封装及特殊封装
2026-01-29 添加RTL8731BU4-Q双频5Gwifi模块的符号和封装
2026-01-29 添加SY8303电源芯片的符号
2026-01-29 更新RY8310电源芯片的符号
2026-01-30 增加CH397以太网卡芯片的符号
2026-01-30 增加网络接口变压器S16116G的符号
2026-01-31 增加SY8029AIC电源芯片的符号和计算数据
2026-02-24 增加MT5050栅极控制器符号
2026-02-24 修正BL-M8731BU4模块的封装
2026-03-18 修改光电开关的符号和封装
2026-03-18 修改5050T的符号
2026-03-19 增加贴片式18650 1S和2S电池座的封装
    [18650_SMD_Battery_Holder_x1.step, 18650_SMD_Battery_Holder_x2.STEP]
2026-03-21 更新E103-RTL8811CU模块的封装数据
2026-03-21 更新GH1.25端子封装
2026-03-21 增加GH1.25端子的3D模型
    [GH1.25-10P-180.step, GH1.25-10P-90.step, GH1.25-11P-180.step, GH1.25-11P-90.step, GH1.25-12P-180.step, GH1.25-12P-90.step, GH1.25-13P-180.step, GH1.25-13P-90.step]
2026-03-24 增加鼠标微动开关的封装
    [D2FC-F-7N.stp]
2026-04-01 补充TF卡槽封装和相应的3D模型
    [TF-Card_push-slot-9P_with_card.step]
2026-04-01 更新压弹式TF卡座的3D模型
2026-04-01 增加16P沉板式Type-C插座的3D模型
    [USB-Type-C_16P_skinning.STEP]
2026-04-01 增加KF2510卧式4P插座封装
    [KF2510-4P_Hor.step]
2026-04-08 更新光电开关的封装
2026-04-08 更新RV09电位器的封装
2026-04-09 增加度云物联doBT-8AM/S无线蓝牙串口芯片符号
2026-04-24 增加EC0606和ZEC11S编码器的封装
2026-04-26 修正6P和16P TYPE-C沉板式插座的封装
2026-04-26 更新自述文件，适配最新的KiCAD 10版本
2026-04-30 增加中移物联ML307模块的符号和封装
2026-04-30 增加ML307模块的3D封装模型
    [ML307.step]
2026-04-30 增加Air724UG模组的3D封装模型
2026-04-30 增加KF2510插座的3D封装模型
    [KF2510-4P.step]
2026-04-30 修正ML307模块关于GNSS天线引脚的修正
2026-05-09 增加1mm、1.5mm和2mm螺丝孔封装
2026-05-09 增加MX1.25插座封装和3D模型
    [MX1.25-11P_THT.stp, MX1.25-4P_SMD_H.stp, MX1.25-4P_SMD_V.stp, MX1.25-4P_THT_H.stp, MX1.25-4P_THT_V.stp, MX1.25-7P_THT.stp]
2026-05-09 更新螺丝孔封装
2026-05-12 增加EC06编码器的封装
2026-05-15 增加步进电机驱动芯片GR2866M的符号
2026-07-17 更新连接器的符号描述
2026-07-17 更新1.27mm排针的直插和贴片封装
2026-07-17 更新USB接口的封装外形
2026-07-18 USB2.0 TYPE-A 直插沉板插座改名
2026-07-18 添加USB2.0 TYPE-A贴片沉板插座封装
2026-07-18 更新USB Type-C沉板插座的封装
2026-07-18 更新6P USB Type-C插座符号的标签
2026-07-18 增加USB Type-C沉板式插座的3D模型
    [USB-Type-C_16P_sinking_0.8mm.STEP, USB-Type-C_16P_sinking_1.6mm.stp, USB-Type-C_6P_sinking_0.8mm.STEP, USB-Type-C_6P_sinking_1.6mm.step]
2026-07-18 更新USB2.0 Type-A沉板式插座的3D模型
    [USB-Type-A_2.0_4P_Sinking_SMD_Short.step, USB-Type-A_2.0_4P_Sinking_THT.stp, USB-Type-A_3.0_9P_Sinking_SMD.stp]
2026-07-18 更新USB Type-C 16P沉板插座的封装轮廓线
2026-07-19 更新Type-C 6P衬板插座封装
2026-07-21 增加JST1.25mm卧贴插座的3D模型
    [JST1.25mm_2P_Hor_SMD.stp]
2026-07-21 增加JST1.25mm卧贴/卧插兼容封装
2026-07-21 JST1.25mm 6P插座封装更名
2026-07-21 更新JST1.25mm 4P插座的封装名称和3D模型
    [JST1.25mm_4P_Hor_SMD.stp, JST1.25mm_4P_Hor_THT.stp, JST1.25mm_4P_Ver_THT.stp]
2026-07-21 更新JST1.25mm 3P插座的封装和3D模型
    [JST1.25mm_3P_Hor_SMD.stp, JST1.25mm_3P_Hor_THT.stp, JST1.25mm_3P_Ver_THT.stp]
2026-07-21 更新JST1.25mm 6P插座的封装描述和3D模型
    [JST1.25mm_6P_Hor_SMD.stp, JST1.25mm_6P_Hor_THT.stp, JST1.25mm_6P_Ver_THT.stp]
2026-07-21 更新JST1.25mm 2P插座的封装和3D模型
    [JST1.25mm_2P_Hor_THT.stp, JST1.25mm_2P_Ver_THT.stp]
2026-07-28 更新PH2.0插座封装
2026-07-28 更新PH2.0卧贴插座封装的3D模型
2026-08-16 增加1.27mm间距4P排针封装
2026-08-20 增加调整引脚布局的ESP32-S3符号
2026-08-20 增加ESP32-C5-WROOM-1模块的符号和封装
2026-08-21 增加修改边缘的PCM12拨动开关的封装
2026-08-25 添加金逸晨1.54in 240×240px触摸屏符号
2026-08-30 增加微雪ESP32-S3 Tiny模块的符号和封装
2026-08-31 修正微雪ESP32S3-Tiny模块符号名的错误
2026-08-31 增加SGM6603升压IC符号
2026-08-31 增加PW5100升压IC符号
2026-09-05 增加BQ25185电源IC的符号和封装
2026-09-05 添加2×6P双排连接器符号
2026-09-05 增加2×6P 2.54mm双排连接器封装
2026-09-05 修正2.54mm双排连接器的备注名称错误
2026-09-05 增加MP2667符号、QFN-10 2x2mm封装和3D模型
2026-09-05 更新2x2mm QFN-10封装的外轮廓
2026-09-27 增加0805NTC电阻兼容封装
2026-10-11 更新ESP32-C5-WROOM-1模块引脚特性错误
2026-10-11 增加SGM2040 LDO芯片符号
2026-10-14 修改TS-1073B按钮的封装外框边缘
2026-10-14 增加4-6P和4-8P的FPC插座封装
2026-10-18 更新符号引脚的属性标记错误
2026-10-20 修正SGM2040与T154B7符号的引脚电气类型
    - SGM2040: OUT 由 input 改为 power_out
    - T154B7-C16-11-TP-V1: LEDA/LEDK 由 power_in 改为 passive，VDDI 由 input 改为 power_in
    - T154B7-C16-11-TP-V1: 叠放的 16 号 GND 由 power_in 改为 passive（与 1 号 GND 共用连接点，隐藏）
2026-10-21 修正RPI系列光电开关封装引脚并整理光电开关符号
    - RPI-221/222/243/246/441C1 焊盘统一为 1=A、2=K、3=C、4=E
    - RPI-2xx 封装按符号编号（pad1=A、pad2=K），不再按手册的 1=K、2=A
    - Optical_Switch、Photointerrupter 从 Button_Switch 移至 Sensor 库
    - 重命名为 Optical_Switch_Reflective、Photointerrupter_Transmissive，并补充中文描述
2026-10-21 新增Append_Sensor封装库并迁移传感器封装
    - 新建 footpins/sensor，移入 RPI-221/222/243/246/441C1 光电开关和 SGP30
    - configs/fp-lib-table 增加 Append_Sensor
    - SGP30 符号 Footprint 改为 Append_Sensor:SGP30
    - README 补充 sensor 封装库说明
2026-10-24 更新ESP32C5模块热焊盘的编号错误
2026-10-24 更新DC-DC电压计算文件
2026-11-02 添加ETA3423和TPS63802电源IC的符号
2026-11-04 更新光电开关的封装描述
2026-11-06 增加ESP32-C5的符号
2026-11-07 增加金逸晨和沃乐康的1.54寸屏幕外形标注封装
